Basar-mte/CapLeg/docs/img/ankle_capstan_drive.png

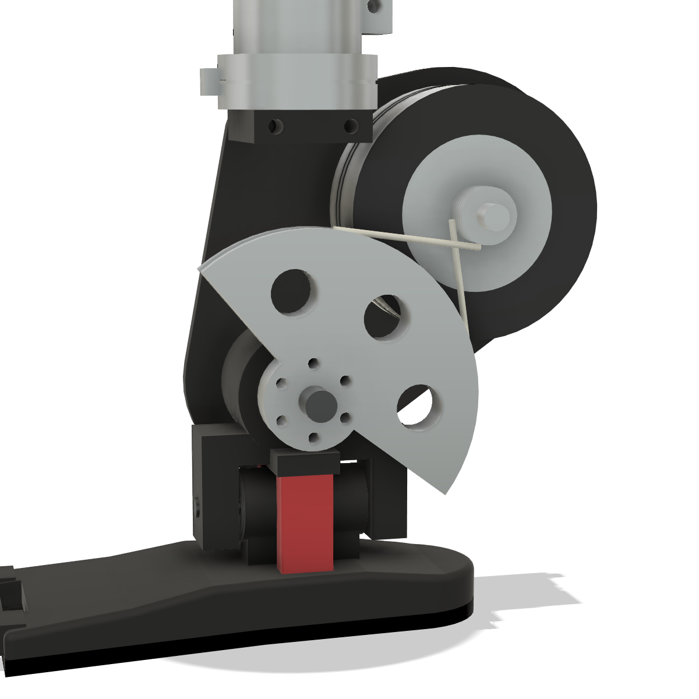
docs/img/ankle_capstan_drive.png
