Basar-mte/CapLeg/docs/img/gait_keyframes.png

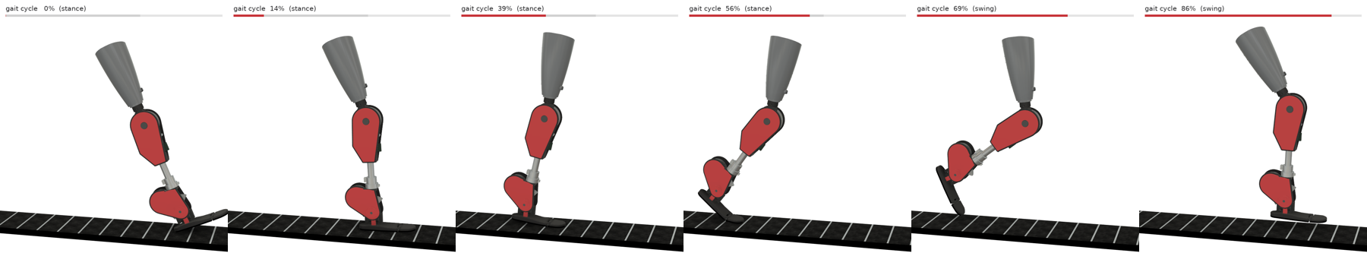
docs/img/gait_keyframes.png
