Basar-mte/CapLeg/docs/img/gait_reference.png

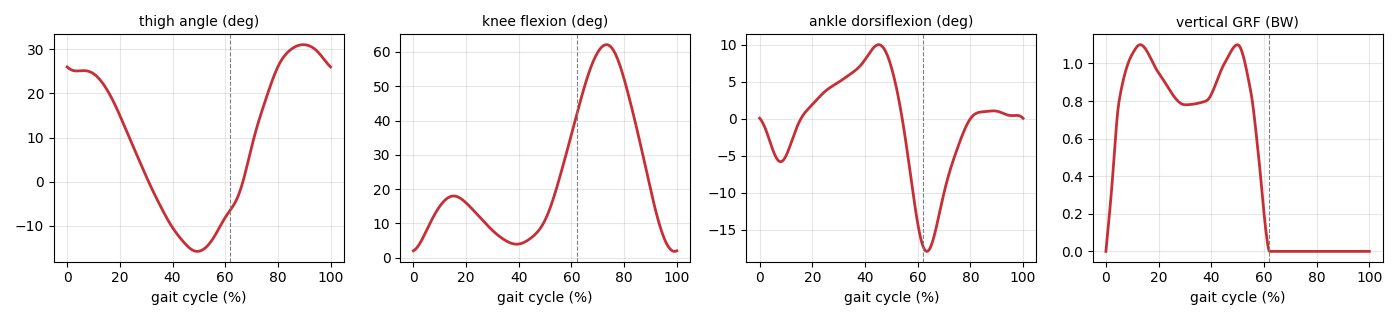
docs/img/gait_reference.png
