Basar-mte/CapLeg/docs/img/knee_capstan_drive.png

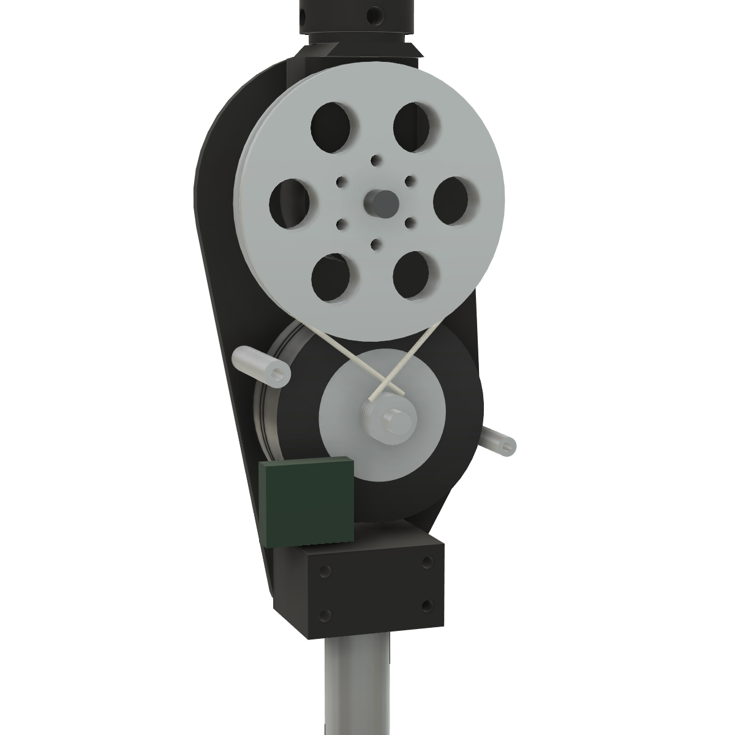
docs/img/knee_capstan_drive.png
