Basar-mte/CapLeg/docs/img/lateral.png

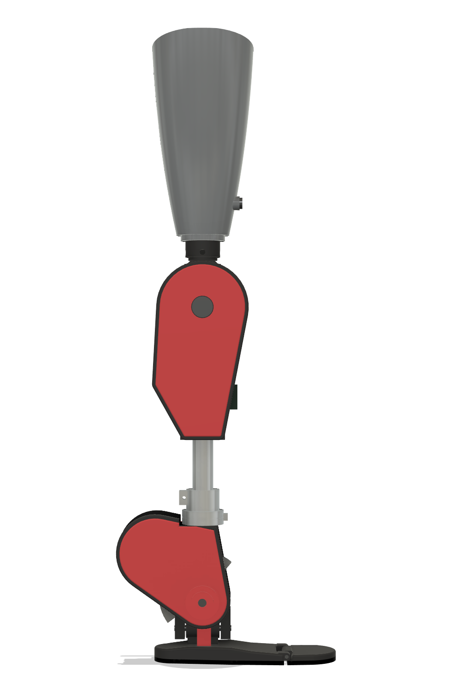
docs/img/lateral.png
