Basar-mte/CapLeg/docs/img/pose_knee120.png

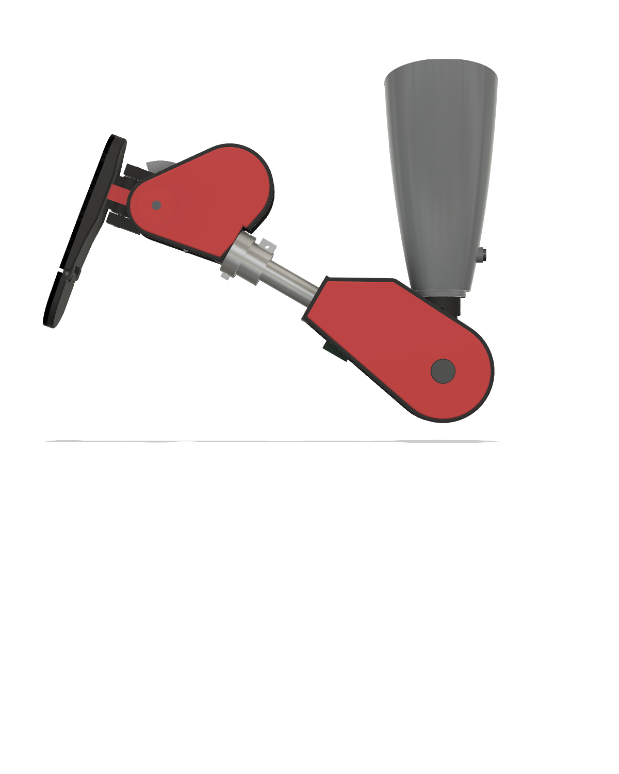
docs/img/pose_knee120.png
