Basar-mte/CapLeg/docs/img/pose_pushoff.png

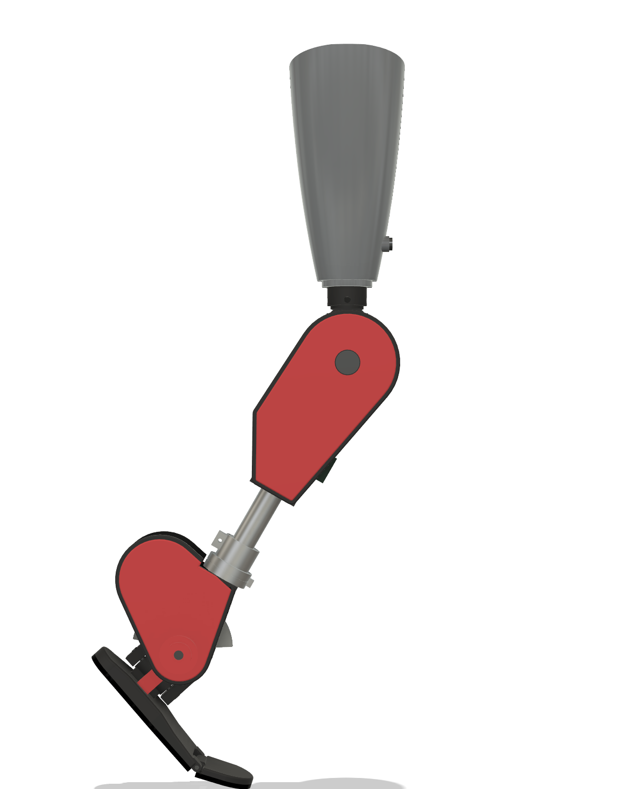
docs/img/pose_pushoff.png
