Basar-mte/CapLeg/docs/img/pose_roll_eversion.png

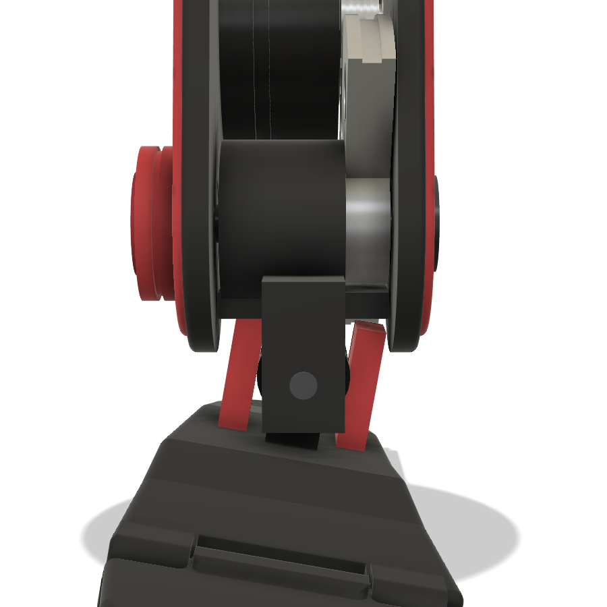
docs/img/pose_roll_eversion.png
