Basar-mte/CapLeg/docs/img/pose_swing.png

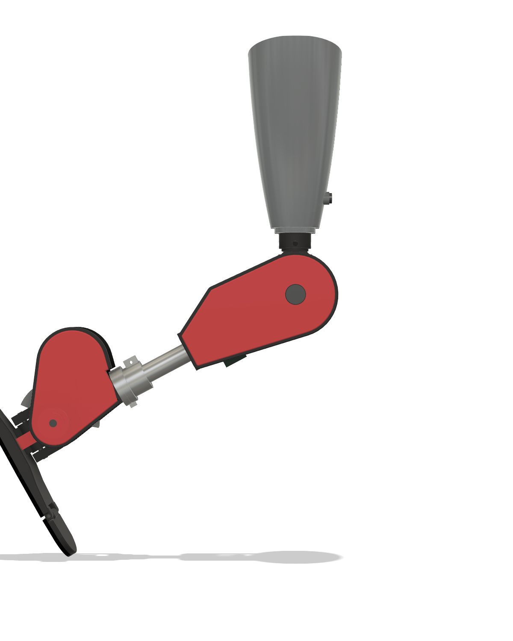
docs/img/pose_swing.png
