Basar-mte/CapLeg/docs/img/rear_medial_iso.png

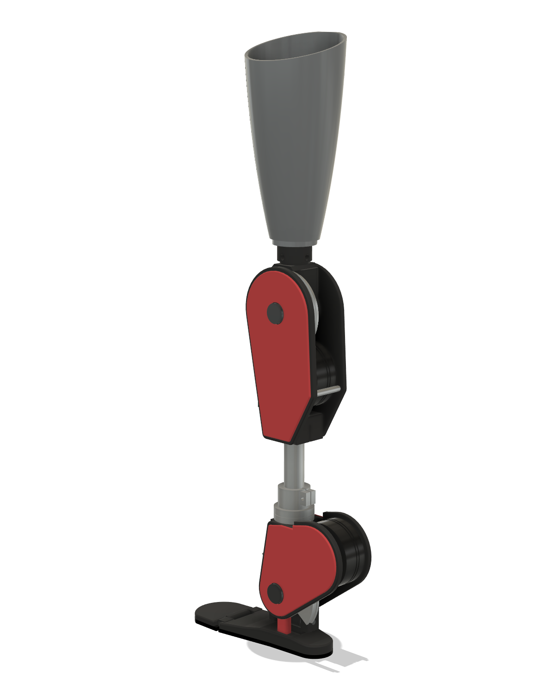
docs/img/rear_medial_iso.png
