Basar-mte/CapLeg/cad/step/CapLeg_assembly.step

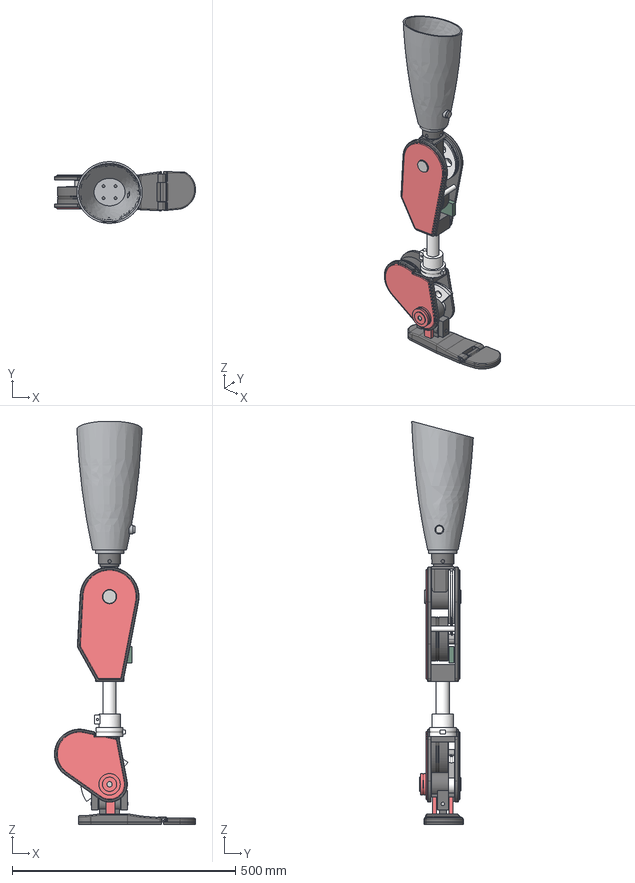
[picture p16: CAD file, 2026-10-10]
cad/step/CapLeg_assembly.step
315.9 x 138.1 x 902.0 mm
CapLeg_Thigh
CapLeg_Shank
CapLeg_Talus
CapLeg_Foot
CapLeg_Toe
