Basar-mte/CapLeg/cad/stl_print/P04_KneeCapstanDisc.stl

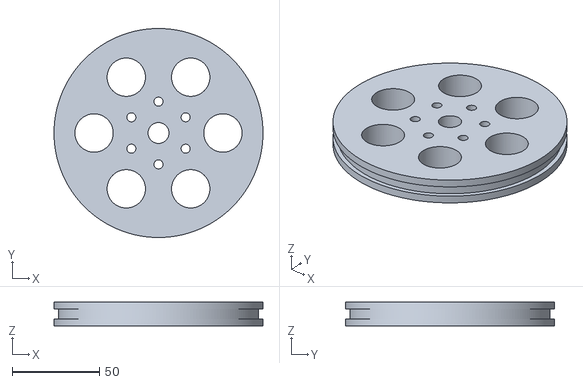
[picture p17: CAD file, 2026-10-10]
cad/stl_print/P04_KneeCapstanDisc.stl
120.0 x 120.0 x 13.5
