Basar-mte/CapLeg/cad/stl_world/H32_OutputFlange.stl

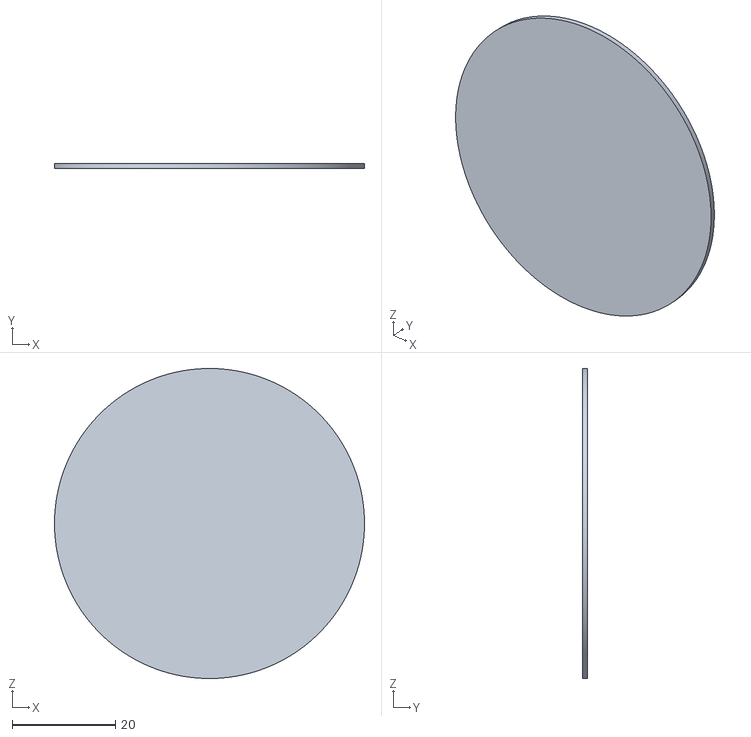
[picture p18: CAD file, 2026-10-10]
cad/stl_world/H32_OutputFlange.stl
60.0 x 1.00 x 60.0
