Basar-mte/CapLeg/mujoco/assets/capleg_shank_pylon__aluminium.stl

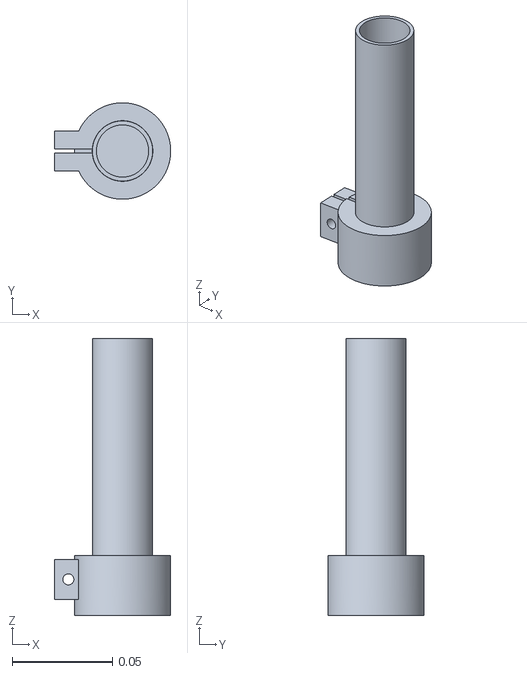
[picture p19: CAD file, 2026-10-10]
mujoco/assets/capleg_shank_pylon__aluminium.stl
0.058 x 0.048 x 0.138
