Basar-mte/CapLeg/ros2_ws/src/capleg_description/meshes/visual/capleg_ankle_module__accent_red.stl

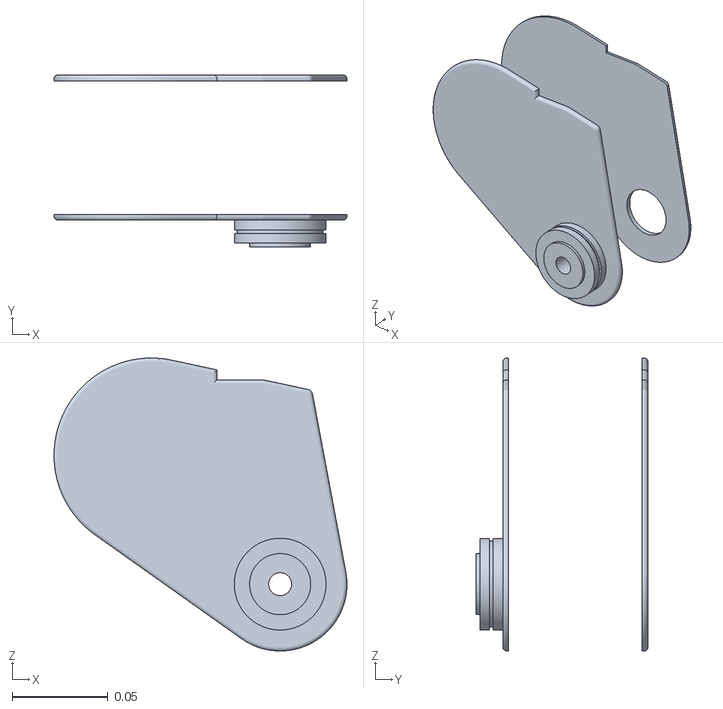
[picture p20: CAD file, 2026-10-10]
ros2_ws/src/capleg_description/meshes/visual/capleg_ankle_module__accent_red.stl
0.153 x 0.09 x 0.153
