Basar-mte/CapLeg/cad/stl_print/P17_PylonClamp_Ankle.stl

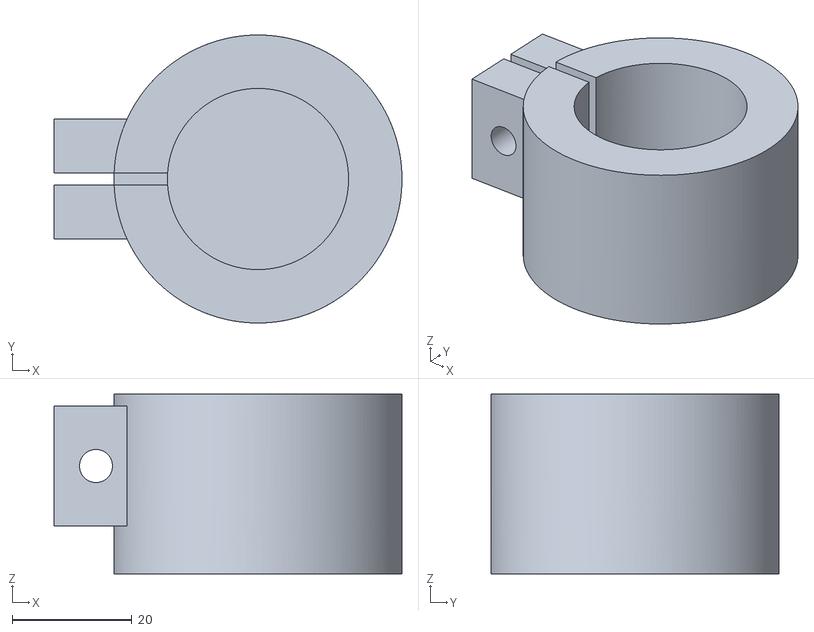
[picture p21: CAD file, 2026-10-10]
cad/stl_print/P17_PylonClamp_Ankle.stl
58.0 x 48.0 x 30.0
