Basar-mte/CapLeg/cad/stl_world/P21_FootKeel.stl

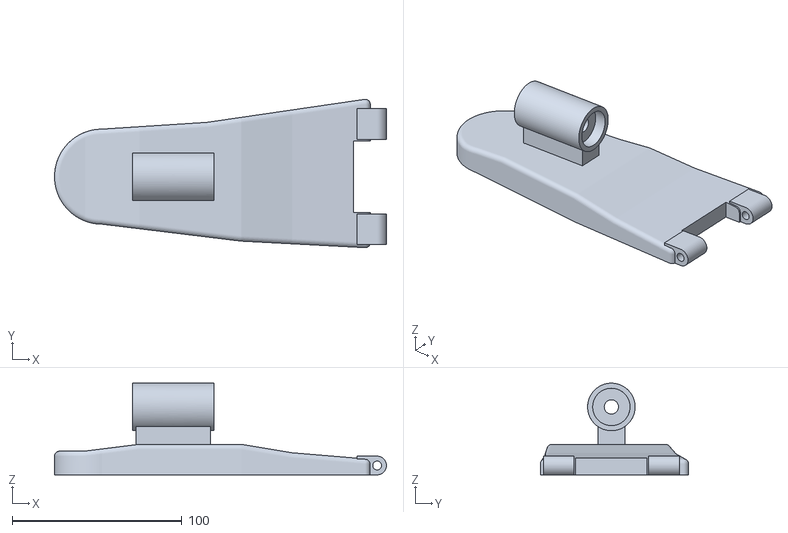
[picture p22: CAD file, 2026-10-10]
cad/stl_world/P21_FootKeel.stl
195.5 x 87.4 x 54.0
