Basar-mte/CapLeg/mujoco/assets/capleg_toe__graphite.stl

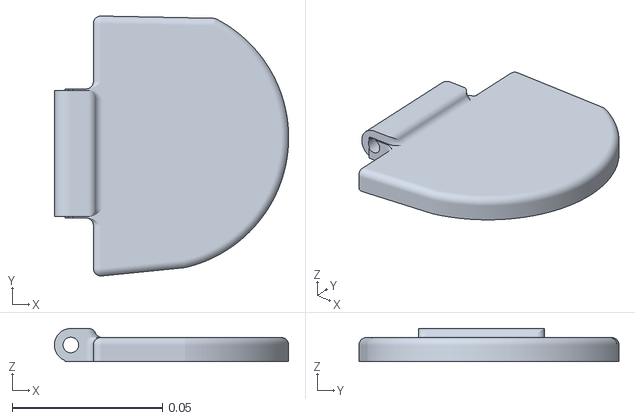
[picture p23: CAD file, 2026-10-10]
mujoco/assets/capleg_toe__graphite.stl
0.078 x 0.0865 x 0.011
