Basar-mte/CapLeg/ros2_ws/src/capleg_description/meshes/visual/capleg_foot__tpu_black.stl

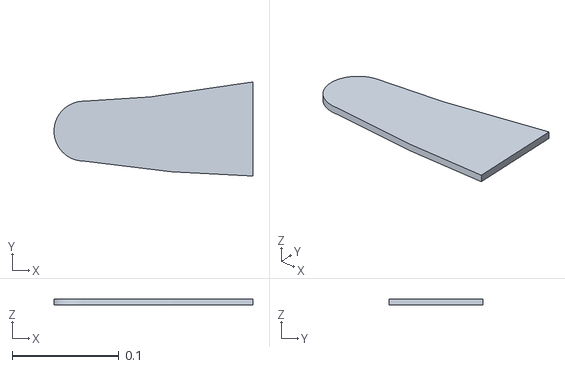
[picture p24: CAD file, 2026-10-10]
ros2_ws/src/capleg_description/meshes/visual/capleg_foot__tpu_black.stl
0.186 x 0.088 x 0.006
