Basar-mte/CapLeg/cad/stl_print/P14_AnkleCover_Lat.stl

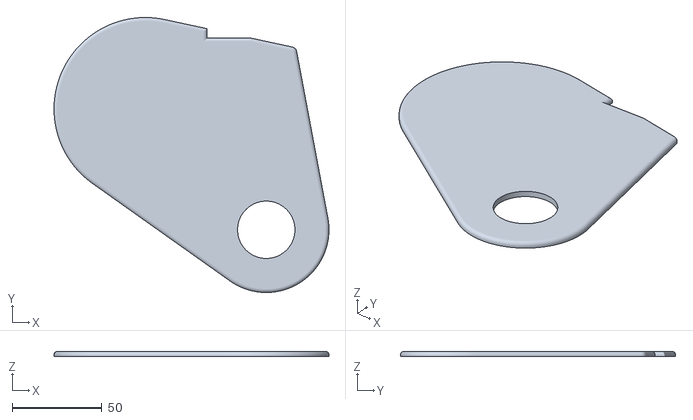
[picture p25: CAD file, 2026-10-10]
cad/stl_print/P14_AnkleCover_Lat.stl
153.4 x 153.4 x 3.00
