Basar-mte/CapLeg/cad/stl_world/P05_KneePlate_Lat.stl

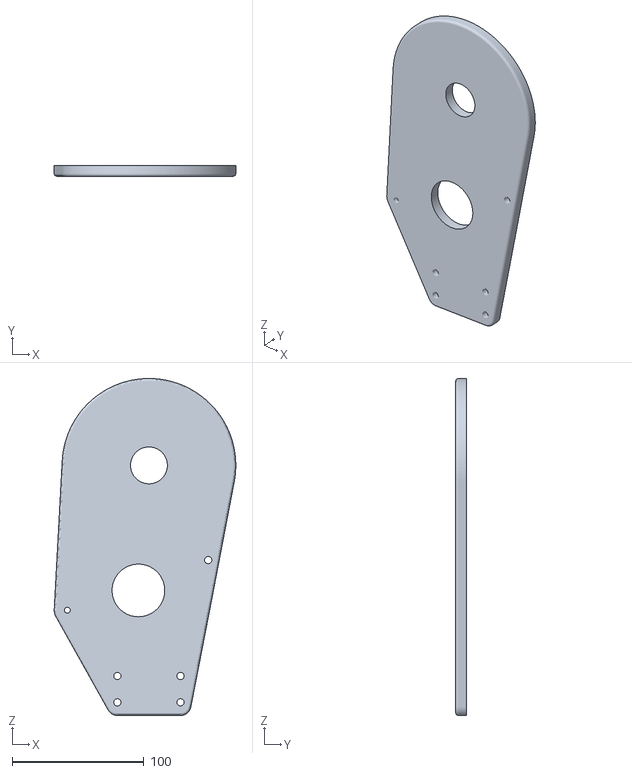
[picture p26: CAD file, 2026-10-10]
cad/stl_world/P05_KneePlate_Lat.stl
138.0 x 8.00 x 256.0
