Basar-mte/CapLeg/mujoco/assets/capleg_thigh__smoke_clear.stl

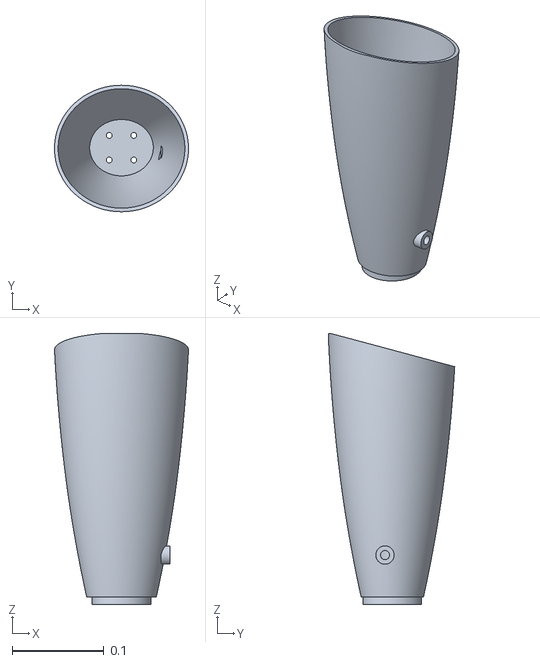
[picture p27: CAD file, 2026-10-10]
mujoco/assets/capleg_thigh__smoke_clear.stl
0.146 x 0.138 x 0.296
