Basar-mte/CapLeg/ros2_ws/src/capleg_description/meshes/visual/capleg_shank_knee__graphite.stl

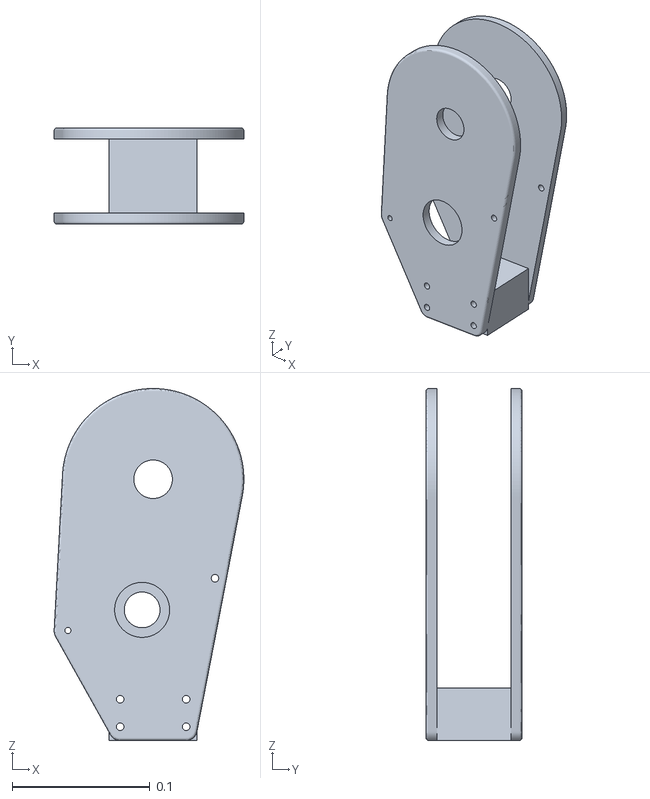
[picture p28: CAD file, 2026-10-10]
ros2_ws/src/capleg_description/meshes/visual/capleg_shank_knee__graphite.stl
0.138 x 0.07 x 0.256
