Basar-mte/CapLeg/cad/stl_print/P03_KneeHead.stl

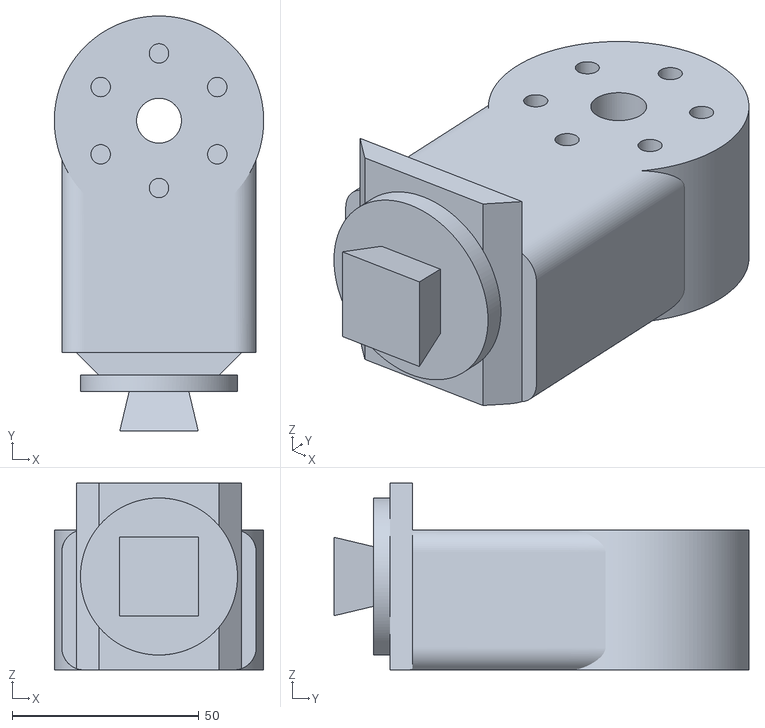
[picture p29: CAD file, 2026-10-10]
cad/stl_print/P03_KneeHead.stl
56.0 x 111.0 x 50.0
