Basar-mte/CapLeg/cad/stl_world/H31_Actuator_AK80-9.stl

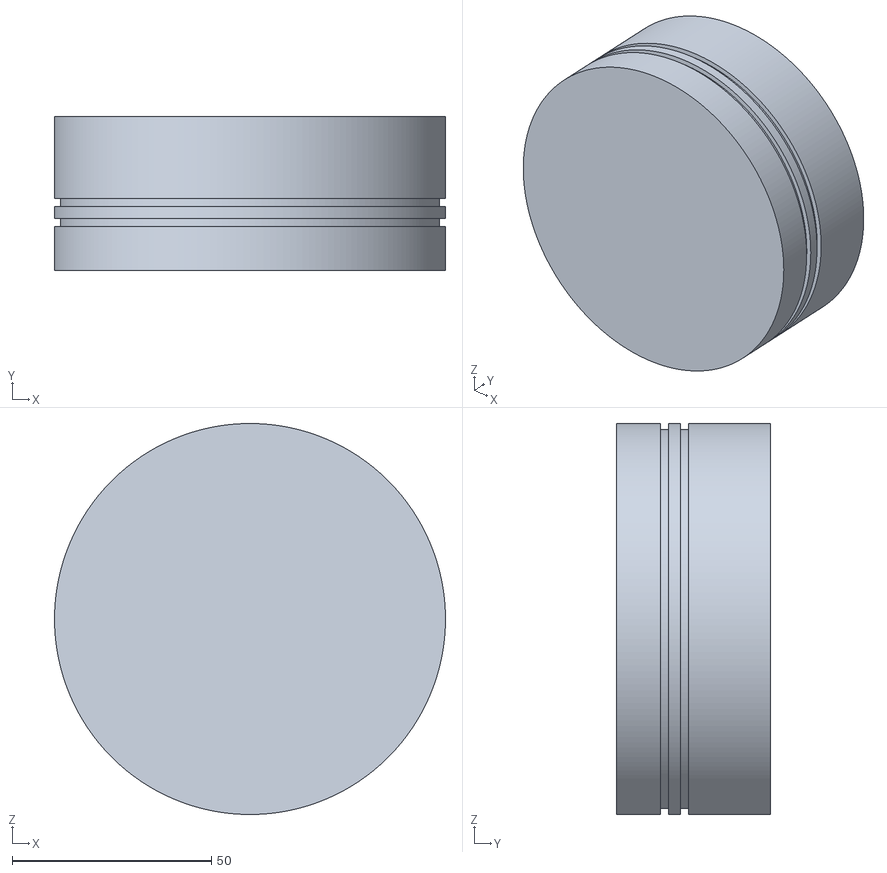
[picture p30: CAD file, 2026-10-10]
cad/stl_world/H31_Actuator_AK80-9.stl
98.0 x 38.5 x 98.0
