Basar-mte/CapLeg/mujoco/assets/capleg_foot__graphite.stl

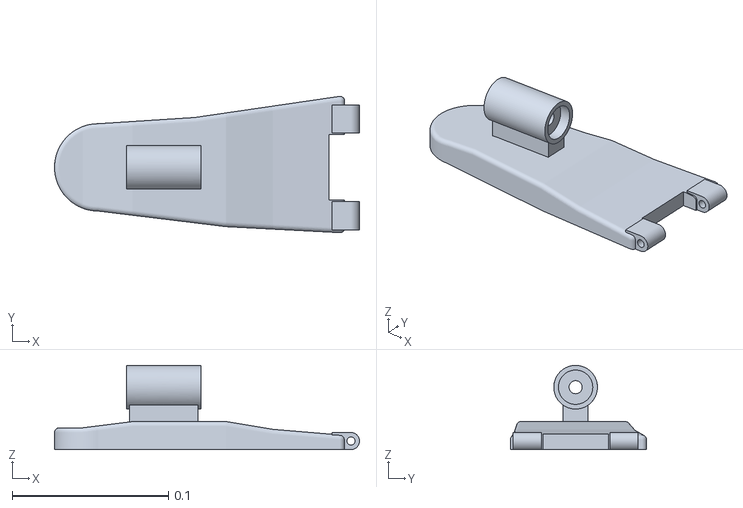
[picture p31: CAD file, 2026-10-10]
mujoco/assets/capleg_foot__graphite.stl
0.195 x 0.0874 x 0.054
