Basar-mte/CapLeg/ros2_ws/src/capleg_description/meshes/visual/capleg_foot__accent_red.stl

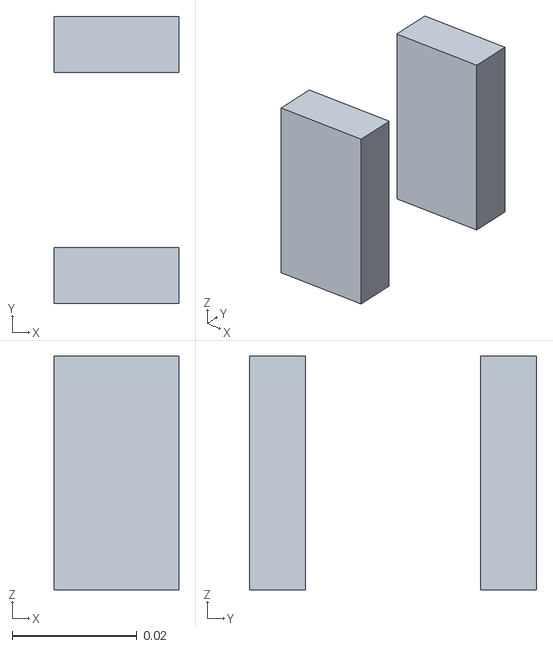
[picture p32: CAD file, 2026-10-10]
ros2_ws/src/capleg_description/meshes/visual/capleg_foot__accent_red.stl
0.02 x 0.046 x 0.0375
