Basar-mte/CapLeg/cad/stl_print/P23_RollSpring_TPU_Med.stl

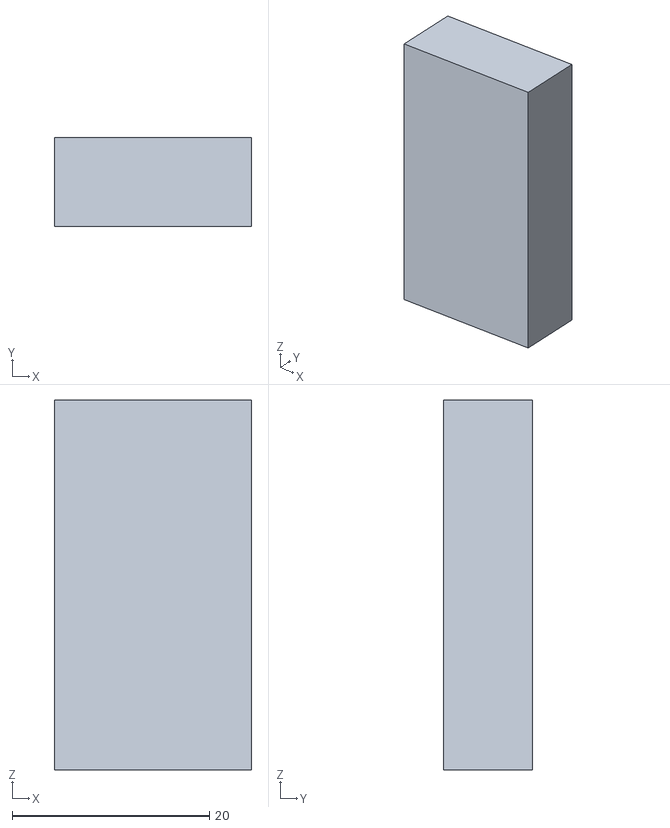
[picture p33: CAD file, 2026-10-10]
cad/stl_print/P23_RollSpring_TPU_Med.stl
20.0 x 9.00 x 37.5
