Basar-mte/CapLeg/mujoco/assets/capleg_talus__steel.stl

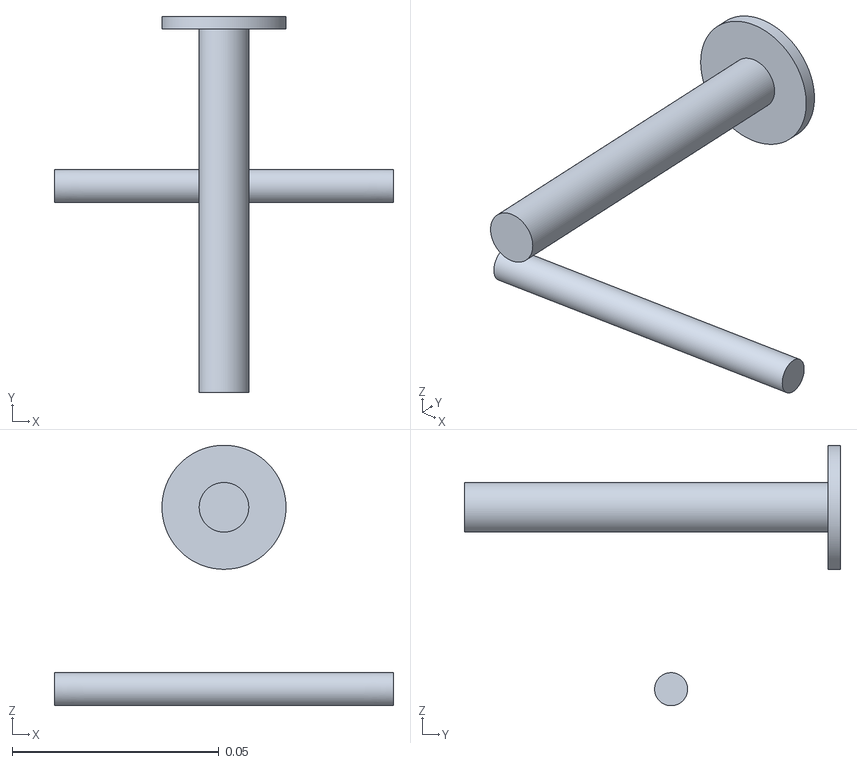
[picture p34: CAD file, 2026-10-10]
mujoco/assets/capleg_talus__steel.stl
0.082 x 0.091 x 0.063
