Basar-mte/CapLeg/ros2_ws/src/capleg_description/meshes/visual/capleg_shank_knee__aluminium.stl

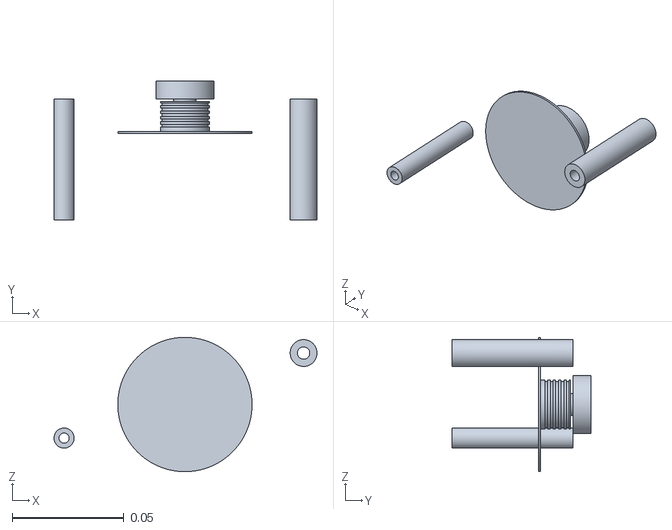
[picture p35: CAD file, 2026-10-10]
ros2_ws/src/capleg_description/meshes/visual/capleg_shank_knee__aluminium.stl
0.117 x 0.062 x 0.06
