Basar-mte/CapLeg/cad/stl_print/P02_PyramidReceiver.stl

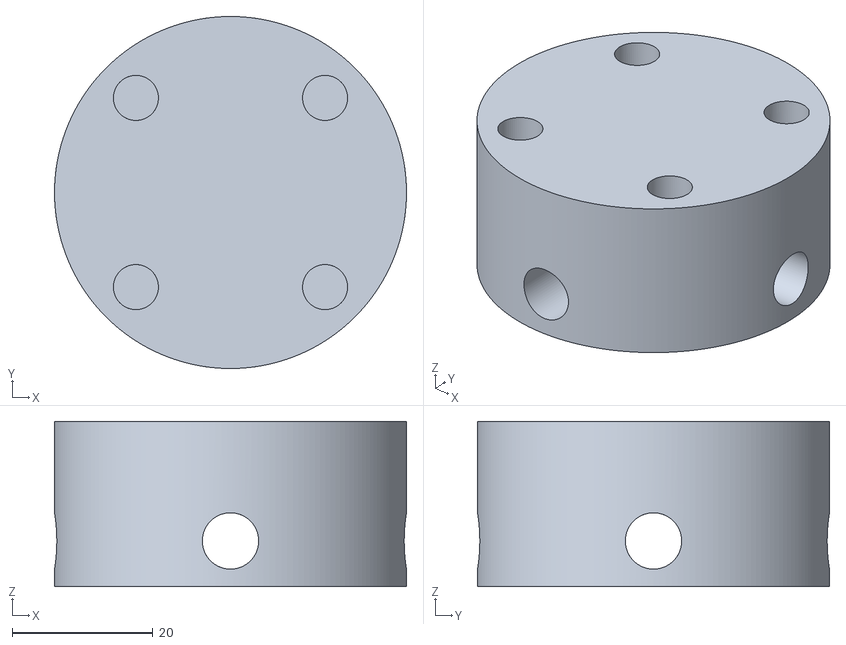
[picture p36: CAD file, 2026-10-10]
cad/stl_print/P02_PyramidReceiver.stl
50.0 x 50.0 x 23.5
