Basar-mte/CapLeg/cad/stl_world/P11_AnklePlate_Lat.stl

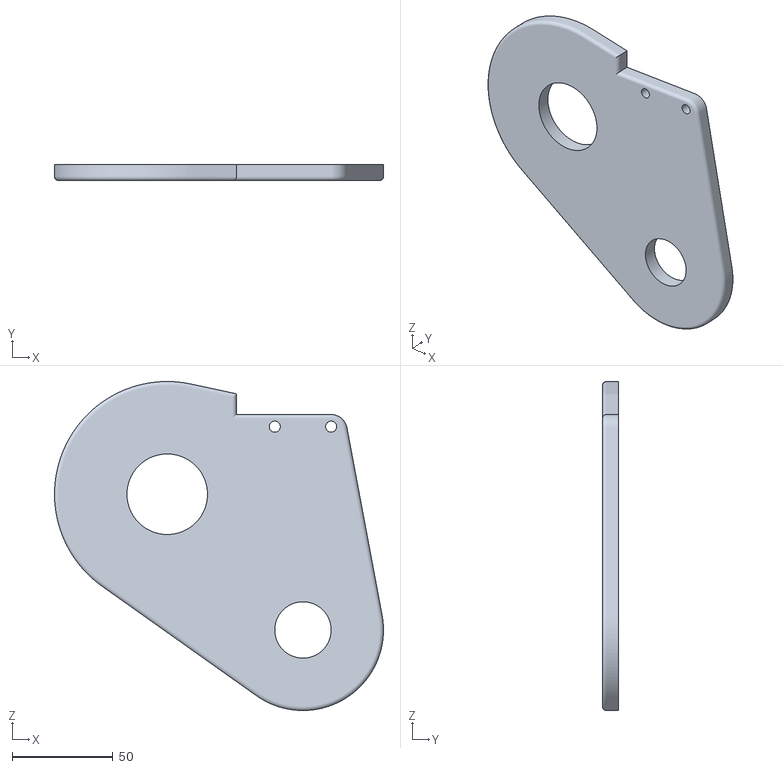
[picture p37: CAD file, 2026-10-10]
cad/stl_world/P11_AnklePlate_Lat.stl
163.4 x 8.00 x 163.4
