Basar-mte/CapLeg/mujoco/assets/capleg_toe__tpu_black.stl

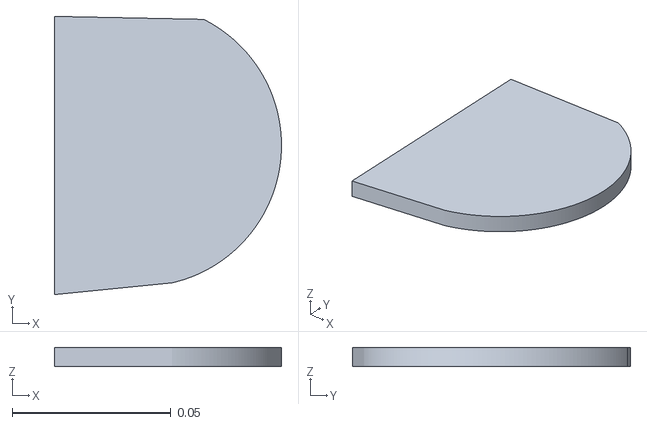
[picture p38: CAD file, 2026-10-10]
mujoco/assets/capleg_toe__tpu_black.stl
0.0715 x 0.0876 x 0.006
