Basar-mte/CapLeg/cad/stl_print/P16_PEA_SpringCartridge.stl

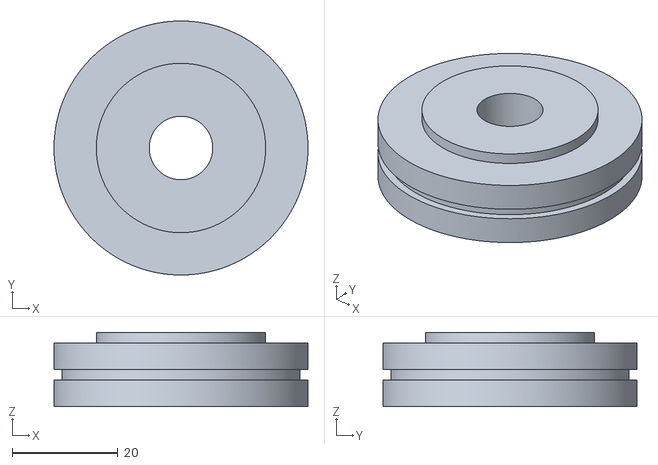
[picture p39: CAD file, 2026-10-10]
cad/stl_print/P16_PEA_SpringCartridge.stl
48.0 x 48.0 x 14.0
