Basar-mte/CapLeg/ros2_ws/src/capleg_description/meshes/visual/capleg_ankle_module__cable_white.stl

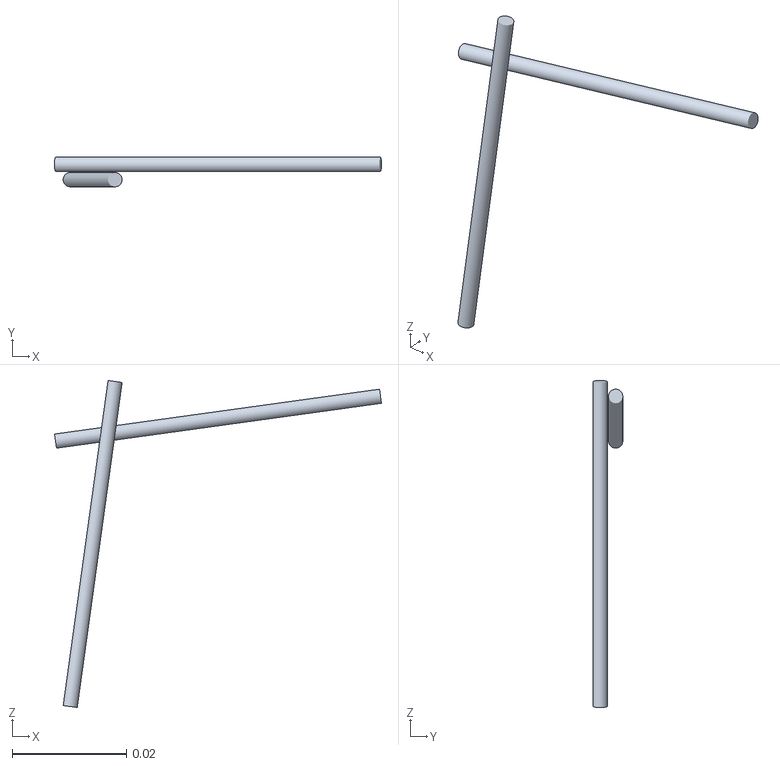
[picture p40: CAD file, 2026-10-10]
ros2_ws/src/capleg_description/meshes/visual/capleg_ankle_module__cable_white.stl
0.0574 x 0.00519 x 0.0574
