Basar-mte/CapLeg/cad/stl_print/P12_AnklePlate_Med.stl

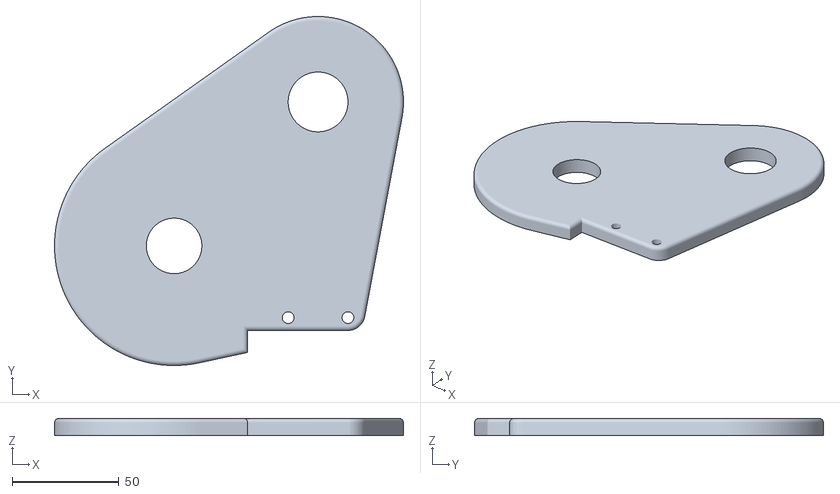
[picture p41: CAD file, 2026-10-10]
cad/stl_print/P12_AnklePlate_Med.stl
163.4 x 163.4 x 8.00
