Basar-mte/CapLeg/mujoco/assets/capleg_ankle_module__aluminium.stl

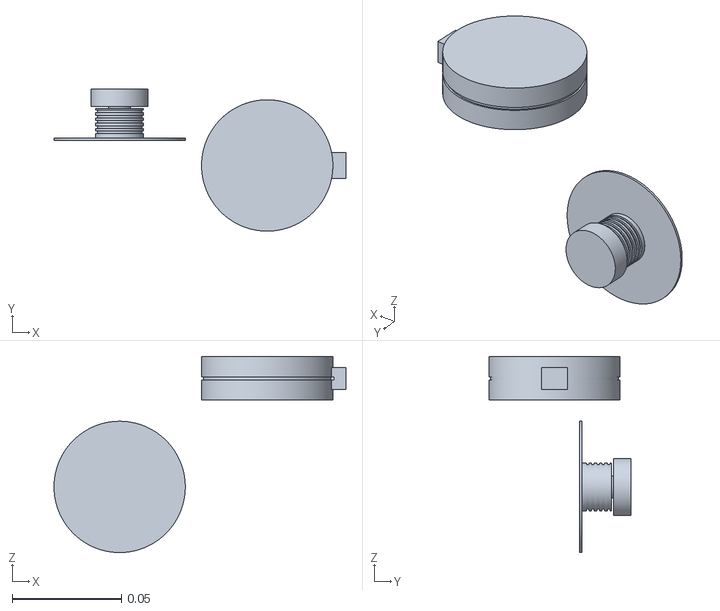
[picture p42: CAD file, 2026-10-10]
mujoco/assets/capleg_ankle_module__aluminium.stl
0.133 x 0.065 x 0.0896
