Basar-mte/CapLeg/ros2_ws/src/capleg_description/meshes/visual/capleg_ankle_module__graphite.stl

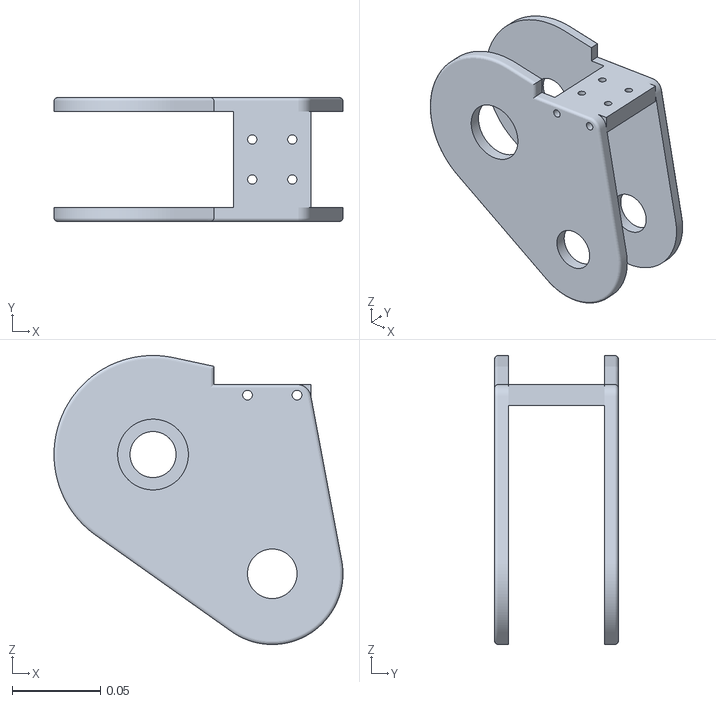
[picture p43: CAD file, 2026-10-10]
ros2_ws/src/capleg_description/meshes/visual/capleg_ankle_module__graphite.stl
0.163 x 0.07 x 0.163
