Basar-mte/CapLeg/cad/stl_print/P06_KneePlate_Med.stl

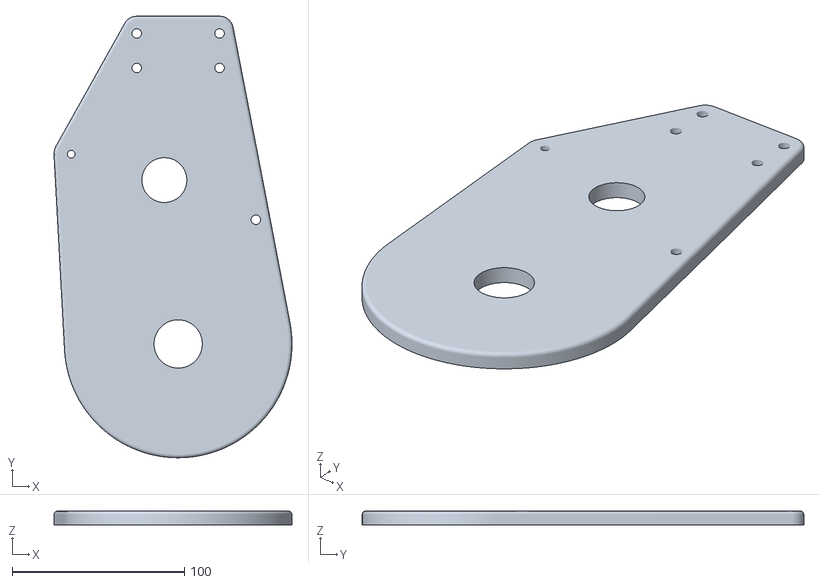
[picture p44: CAD file, 2026-10-10]
cad/stl_print/P06_KneePlate_Med.stl
138.0 x 256.0 x 8.00
