Basar-mte/CapLeg/cad/stl_world/P20_AnkleCapstanSector.stl

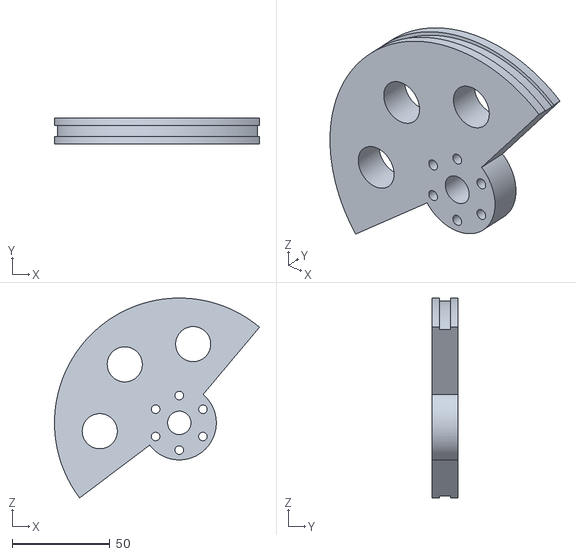
[picture p45: CAD file, 2026-10-10]
cad/stl_world/P20_AnkleCapstanSector.stl
105.1 x 13.5 x 102.5
