Basar-mte/CapLeg/mujoco/assets/capleg_shank_knee__steel.stl

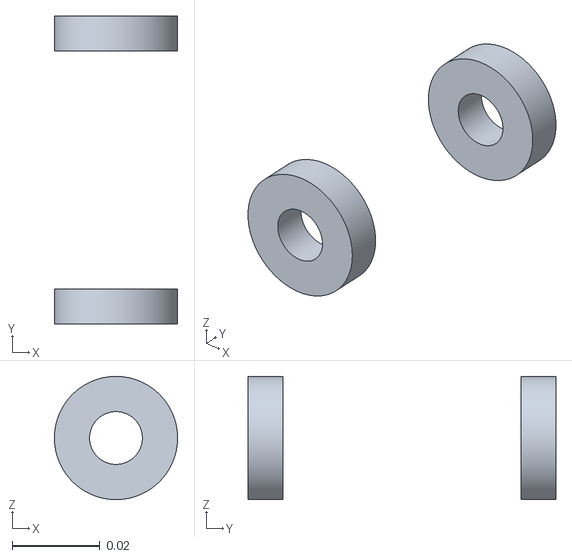
[picture p46: CAD file, 2026-10-10]
mujoco/assets/capleg_shank_knee__steel.stl
0.028 x 0.07 x 0.028
