Basar-mte/CapLeg/cad/stl_print/P13_AnkleTopBlock.stl

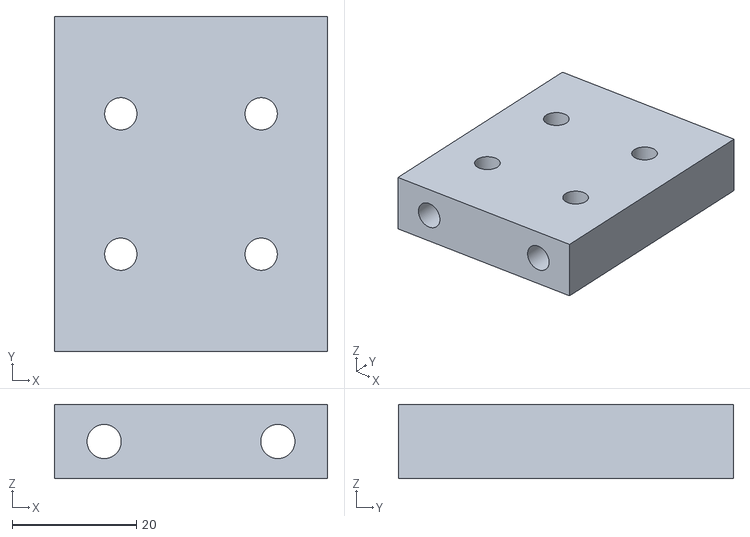
[picture p47: CAD file, 2026-10-10]
cad/stl_print/P13_AnkleTopBlock.stl
44.0 x 54.0 x 12.0
