Basar-mte/CapLeg/cad/stl_world/P10_CapstanDrum.stl

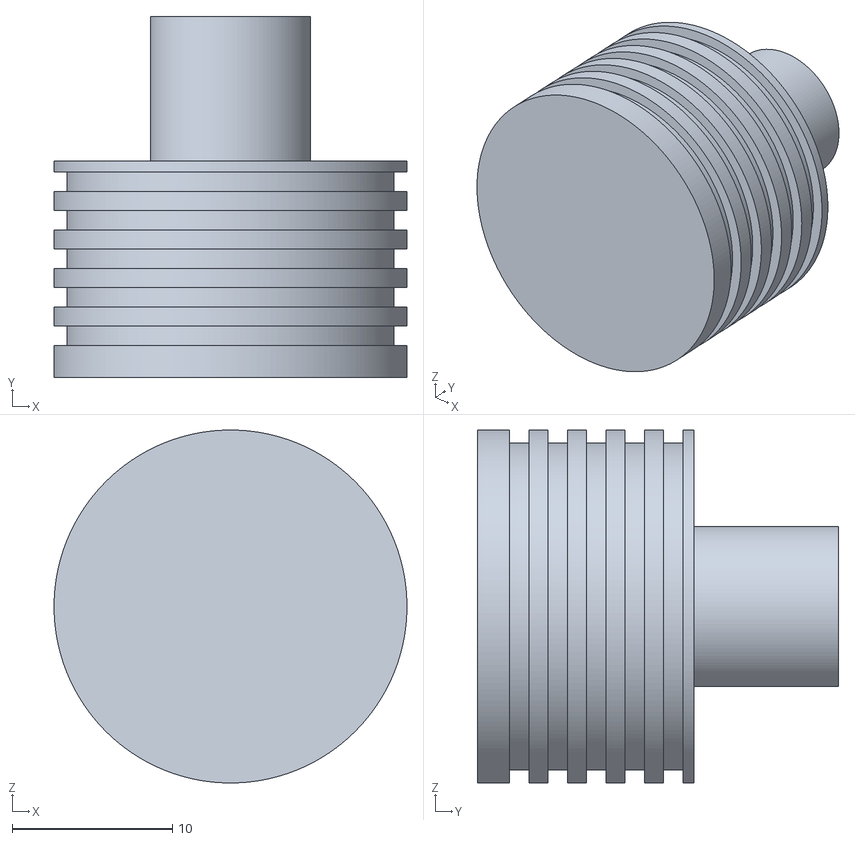
[picture p48: CAD file, 2026-10-10]
cad/stl_world/P10_CapstanDrum.stl
22.0 x 22.5 x 22.0
