Basar-mte/CapLeg/mujoco/assets/capleg_thigh__steel.stl

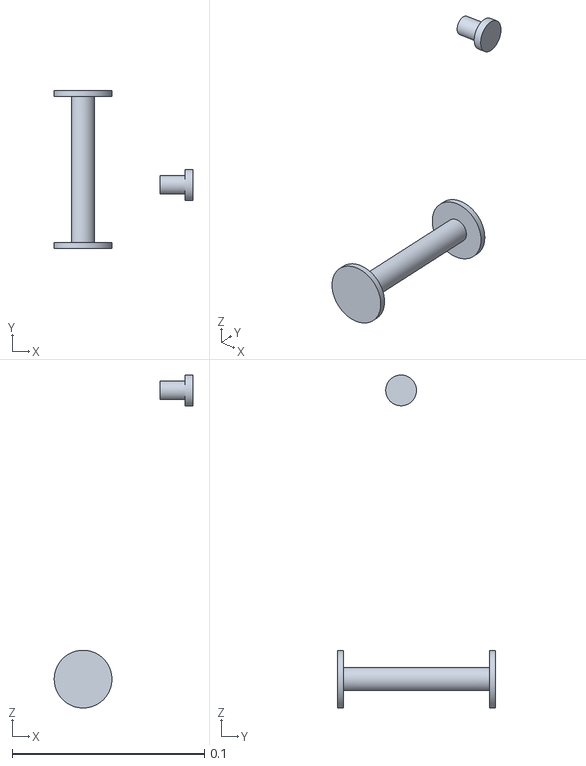
[picture p49: CAD file, 2026-10-10]
mujoco/assets/capleg_thigh__steel.stl
0.072 x 0.082 x 0.173
