Basar-mte/CapLeg/cad/stl_world/H13_KneeCable_2.stl

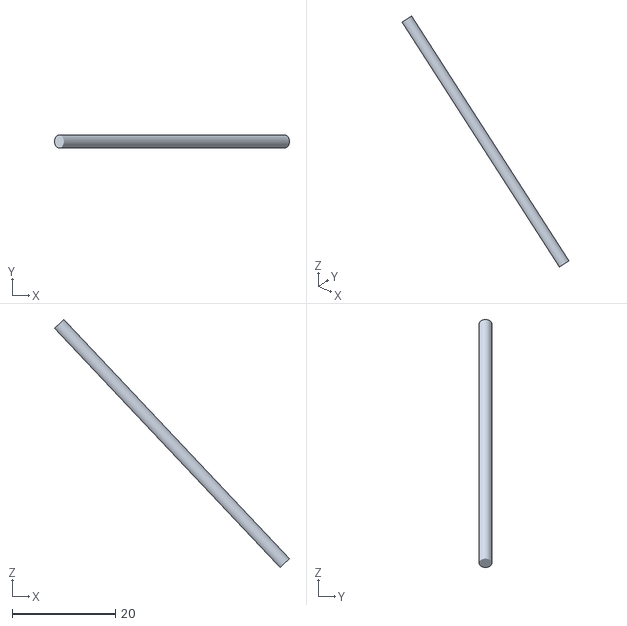
[picture p50: CAD file, 2026-10-10]
cad/stl_world/H13_KneeCable_2.stl
45.5 x 2.50 x 48.0
