Basar-mte/CapLeg/ros2_ws/src/capleg_description/meshes/visual/capleg_thigh__aluminium.stl

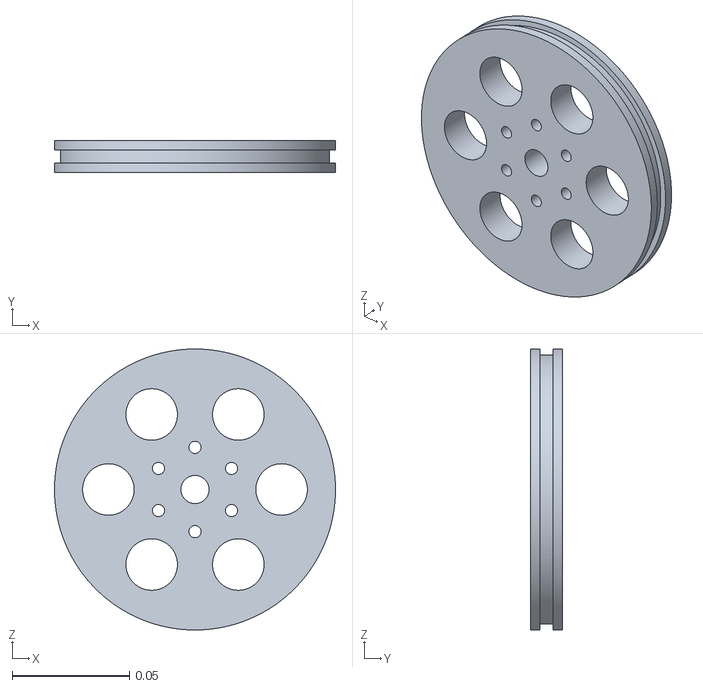
[picture p51: CAD file, 2026-10-10]
ros2_ws/src/capleg_description/meshes/visual/capleg_thigh__aluminium.stl
0.12 x 0.0135 x 0.12
