Basar-mte/CapLeg/cad/stl_world/H02_KneeCap_Lat.stl

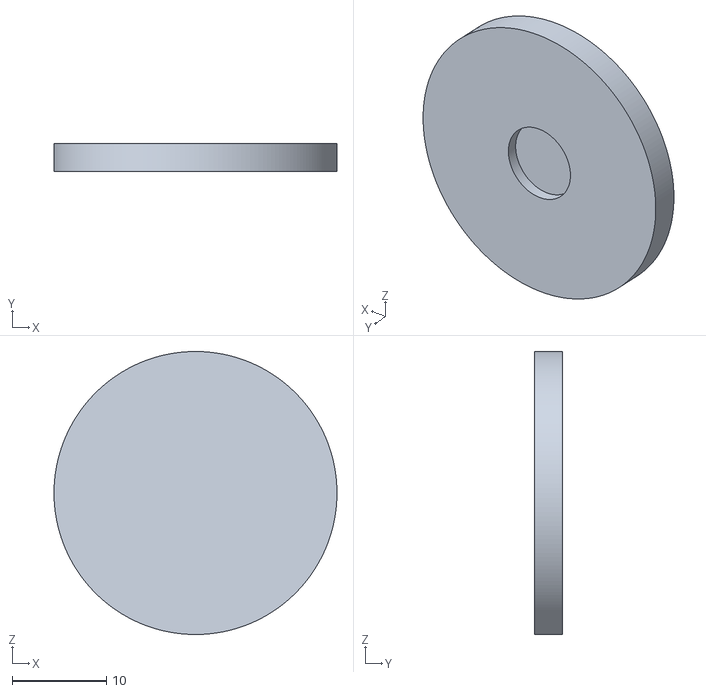
[picture p52: CAD file, 2026-10-10]
cad/stl_world/H02_KneeCap_Lat.stl
30.0 x 3.00 x 30.0
