Basar-mte/CapLeg/mujoco/assets/capleg_shank_knee__accent_red.stl

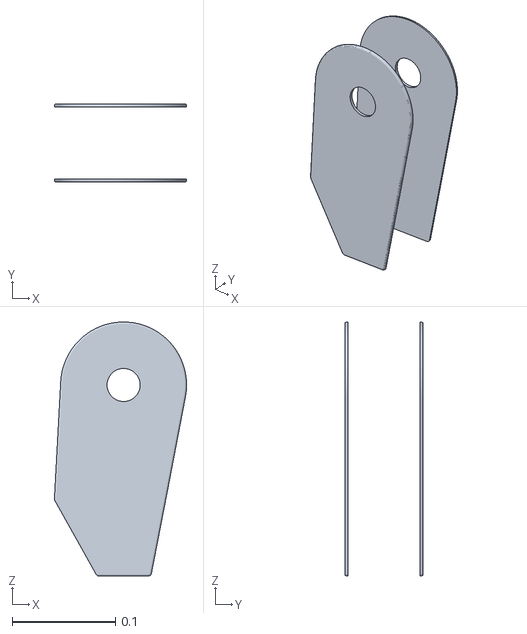
[picture p53: CAD file, 2026-10-10]
mujoco/assets/capleg_shank_knee__accent_red.stl
0.128 x 0.076 x 0.246
