Basar-mte/CapLeg/cad/stl_world/H21_LoadCell_6axis.stl

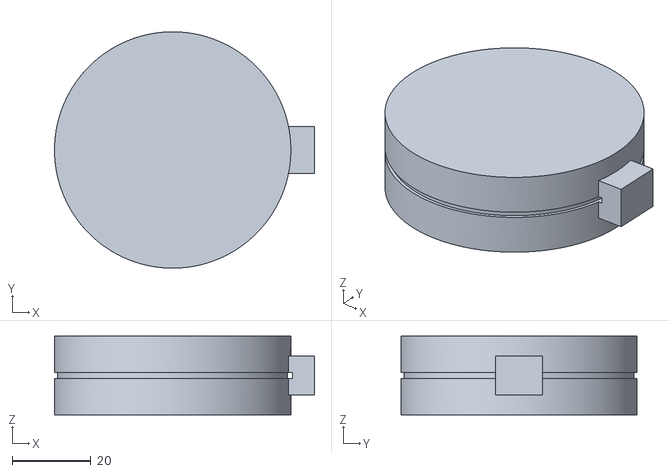
[picture p54: CAD file, 2026-10-10]
cad/stl_world/H21_LoadCell_6axis.stl
66.0 x 60.0 x 20.0
