Basar-mte/CapLeg/cad/stl_print/P22_SolePad_TPU.stl

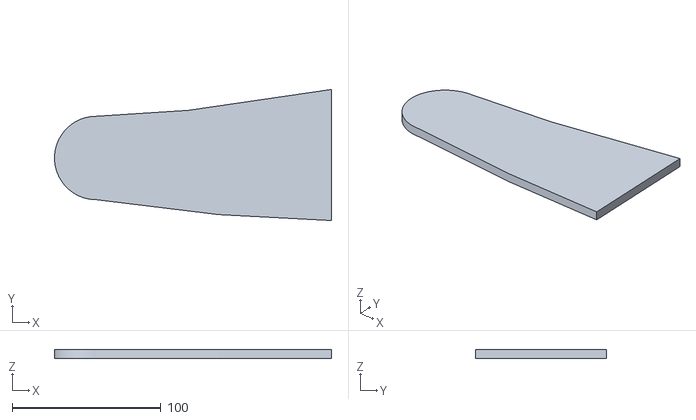
[picture p55: CAD file, 2026-10-10]
cad/stl_print/P22_SolePad_TPU.stl
186.0 x 88.0 x 6.00
