Basar-mte/CapLeg/cad/stl_print/P25_ToePad_TPU.stl

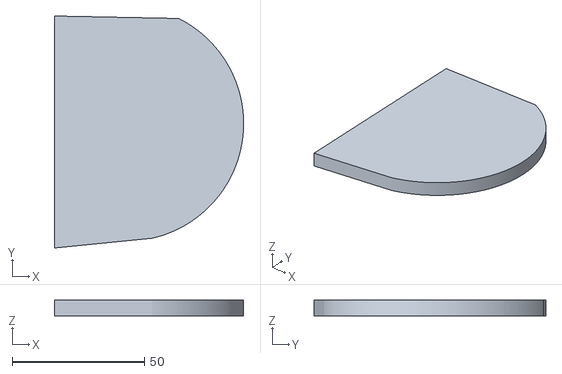
[picture p56: CAD file, 2026-10-10]
cad/stl_print/P25_ToePad_TPU.stl
71.5 x 87.6 x 6.00
