Basar-mte/CapLeg/cad/stl_world/H13_KneeCable_1.stl

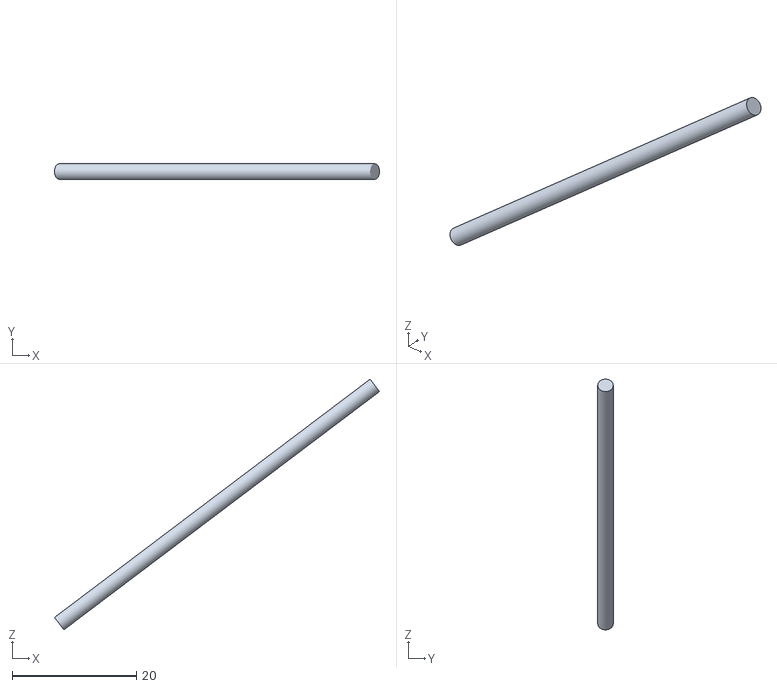
[picture p57: CAD file, 2026-10-10]
cad/stl_world/H13_KneeCable_1.stl
52.3 x 2.50 x 40.3
