Basar-mte/CapLeg/mujoco/assets/capleg_talus__graphite.stl

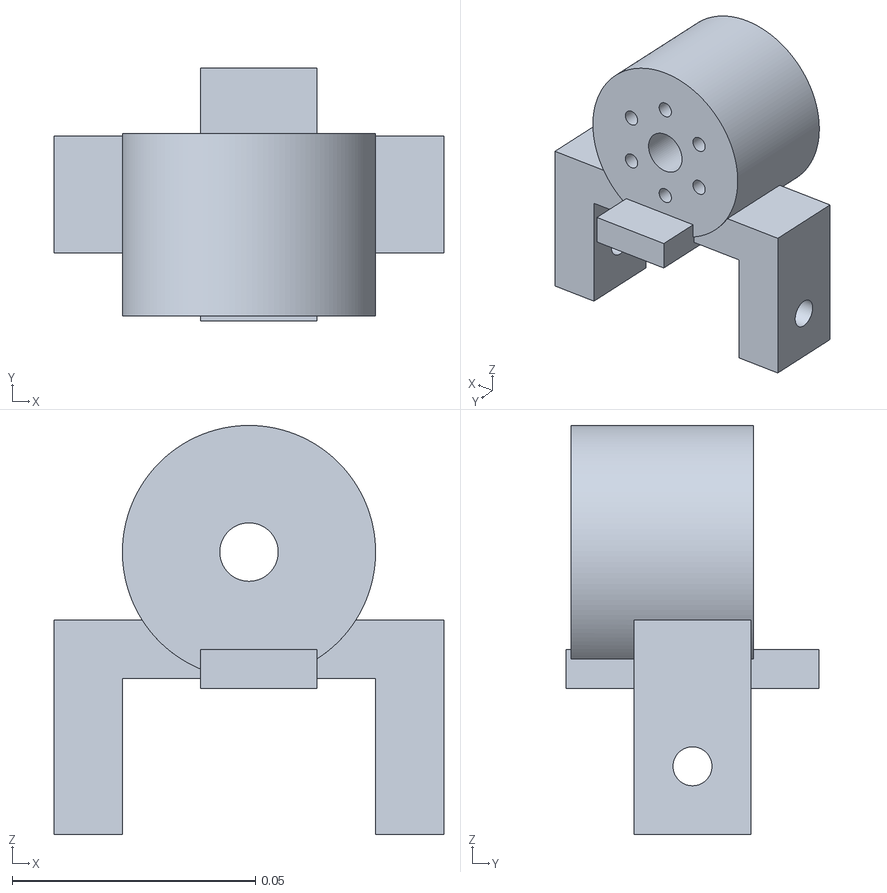
[picture p58: CAD file, 2026-10-10]
mujoco/assets/capleg_talus__graphite.stl
0.08 x 0.052 x 0.084
