Basar-mte/CapLeg/cad/stl_print/P08_KneeCover_Lat.stl

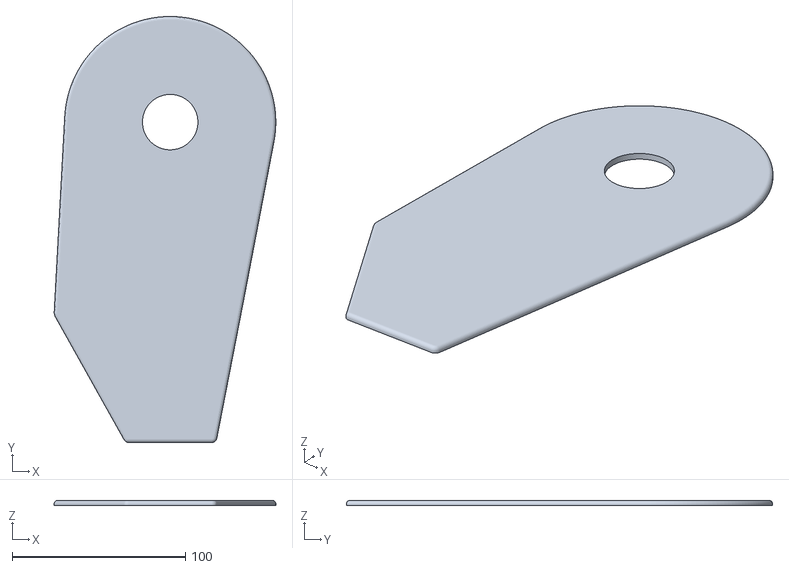
[picture p59: CAD file, 2026-10-10]
cad/stl_print/P08_KneeCover_Lat.stl
128.0 x 246.0 x 3.00
