Basar-mte/CapLeg/ros2_ws/src/capleg_description/meshes/visual/capleg_shank_knee__cable_white.stl

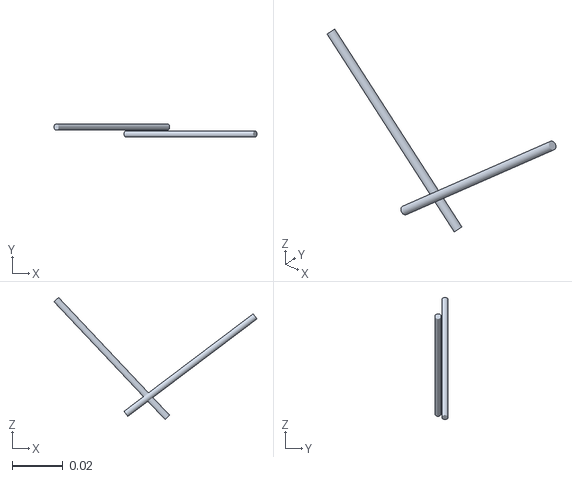
[picture p60: CAD file, 2026-10-10]
ros2_ws/src/capleg_description/meshes/visual/capleg_shank_knee__cable_white.stl
0.0798 x 0.0052 x 0.048
