Basar-mte/CapLeg/cad/stl_print/P07_KneeClamp.stl

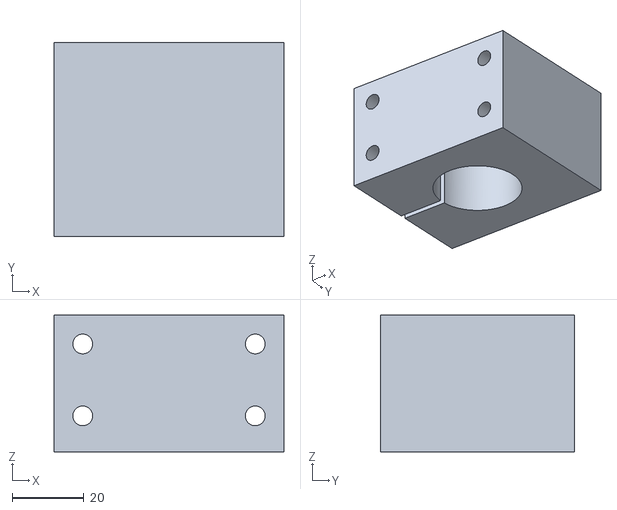
[picture p61: CAD file, 2026-10-10]
cad/stl_print/P07_KneeClamp.stl
64.0 x 54.0 x 38.0
