Basar-mte/CapLeg/cad/stl_world/H51_Bearing608_Ant.stl

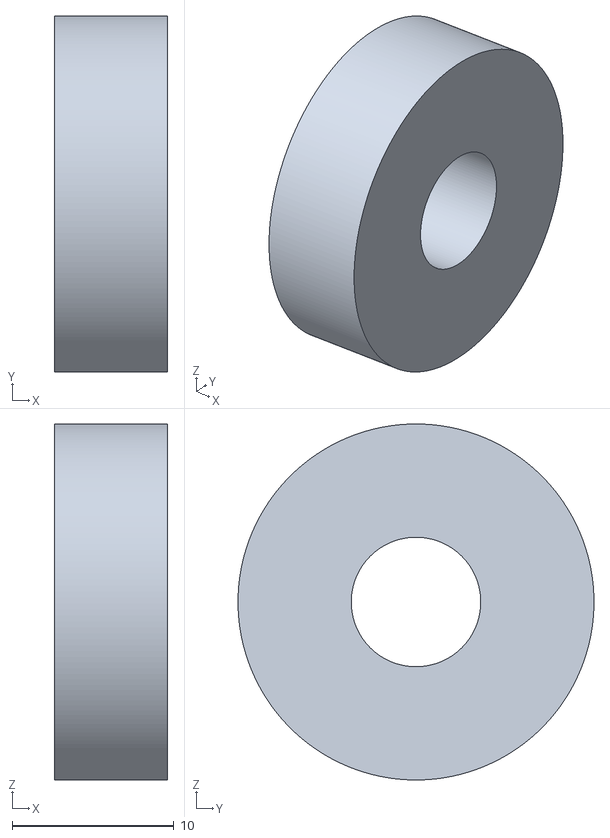
[picture p62: CAD file, 2026-10-10]
cad/stl_world/H51_Bearing608_Ant.stl
7.00 x 22.0 x 22.0
