Basar-mte/CapLeg/mujoco/assets/capleg_foot__steel.stl

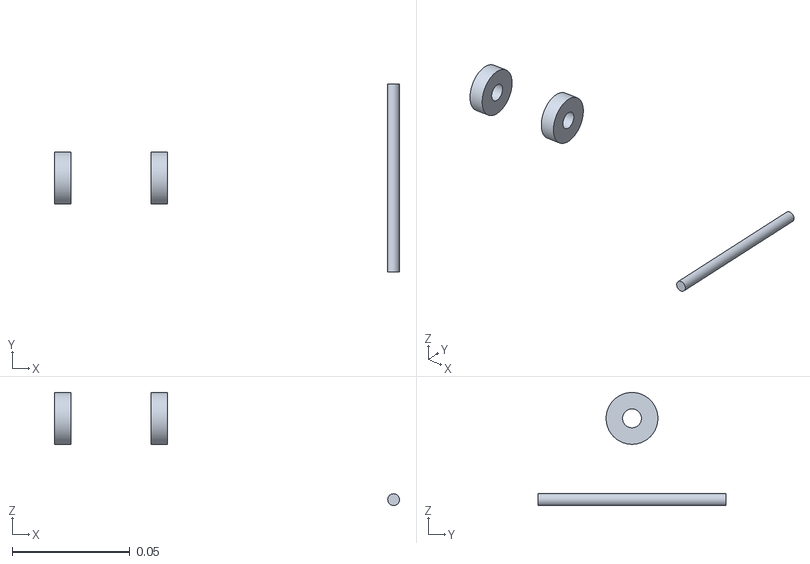
[picture p63: CAD file, 2026-10-10]
mujoco/assets/capleg_foot__steel.stl
0.147 x 0.08 x 0.048
