Basar-mte/CapLeg/ros2_ws/src/capleg_description/meshes/visual/capleg_ankle_module__actuator_black.stl

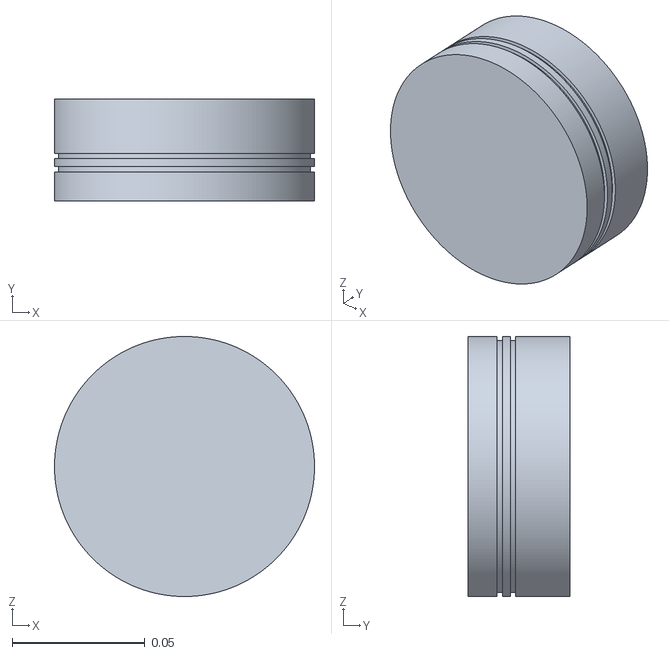
[picture p64: CAD file, 2026-10-10]
ros2_ws/src/capleg_description/meshes/visual/capleg_ankle_module__actuator_black.stl
0.098 x 0.0385 x 0.098
