Basar-mte/CapLeg/mujoco/assets/capleg_talus__aluminium.stl

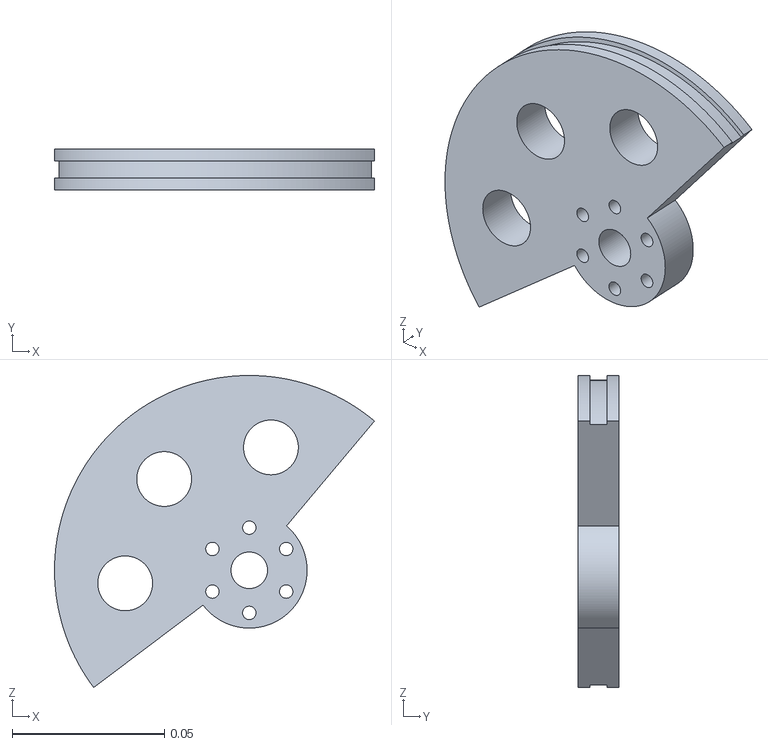
[picture p65: CAD file, 2026-10-10]
mujoco/assets/capleg_talus__aluminium.stl
0.105 x 0.0135 x 0.103
