Basar-mte/CapLeg/cad/stl_print/P24_Toe.stl

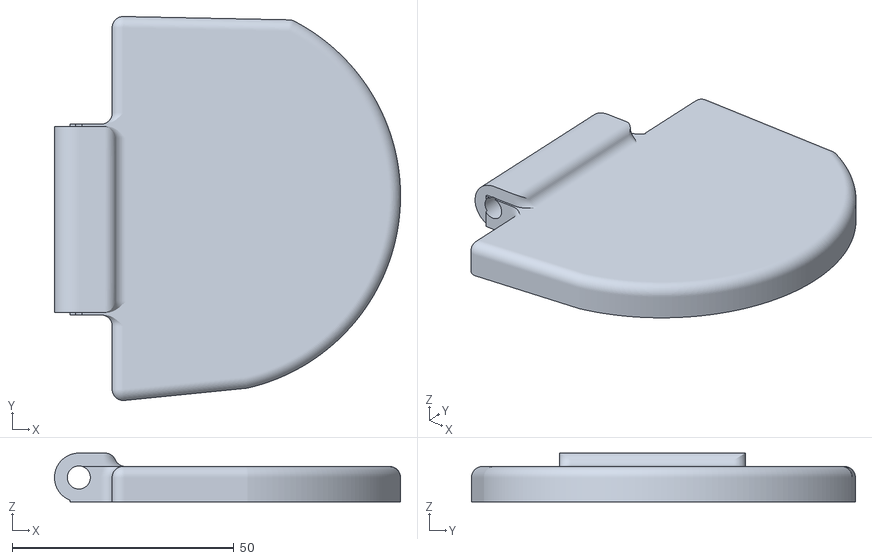
[picture p66: CAD file, 2026-10-10]
cad/stl_print/P24_Toe.stl
78.0 x 86.5 x 11.0
