Basar-mte/CapLeg/ros2_ws/src/capleg_description/meshes/visual/capleg_shank_knee__pcb_green.stl

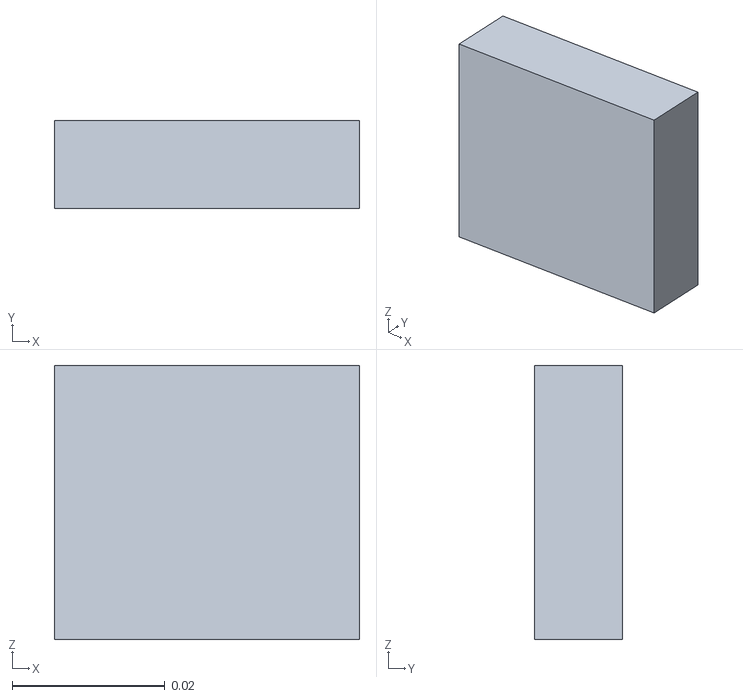
[picture p67: CAD file, 2026-10-10]
ros2_ws/src/capleg_description/meshes/visual/capleg_shank_knee__pcb_green.stl
0.04 x 0.0115 x 0.036
