Basar-mte/CapLeg/cad/stl_world/H14_AnkleCable_2.stl

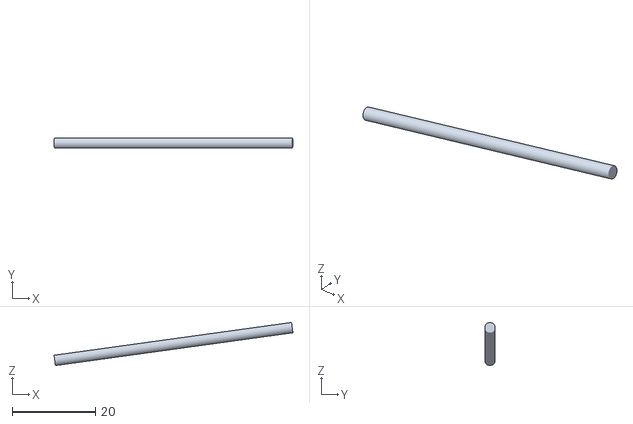
[picture p68: CAD file, 2026-10-10]
cad/stl_world/H14_AnkleCable_2.stl
57.4 x 2.49 x 10.3
