Basar-mte/CapLeg/mujoco/assets/capleg_thigh__graphite.stl

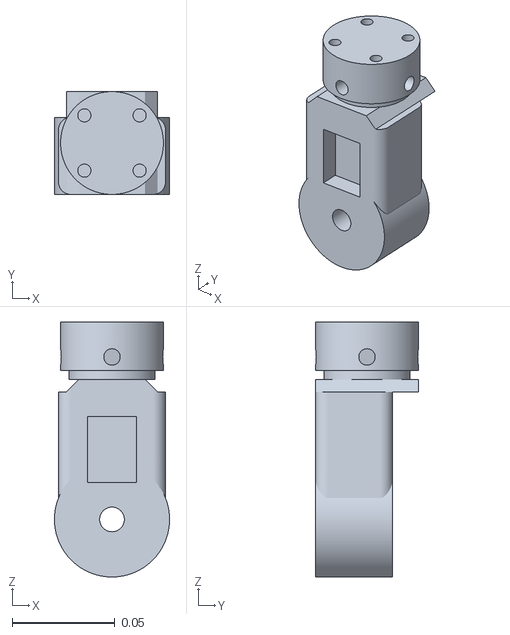
[picture p69: CAD file, 2026-10-10]
mujoco/assets/capleg_thigh__graphite.stl
0.056 x 0.05 x 0.124
