Basar-mte/CapLeg/cad/stl_world/H01_KneeAxle_D12.stl

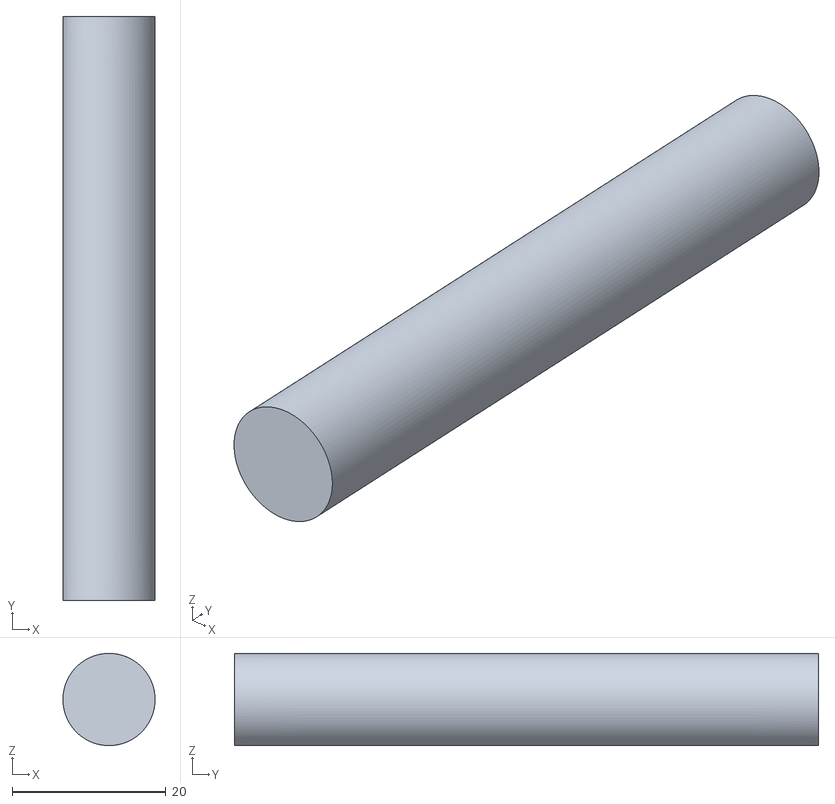
[picture p70: CAD file, 2026-10-10]
cad/stl_world/H01_KneeAxle_D12.stl
12.0 x 76.0 x 12.0
