Basar-mte/CapLeg/cad/stl_world/H10_Bearing6001_AnkleLat.stl

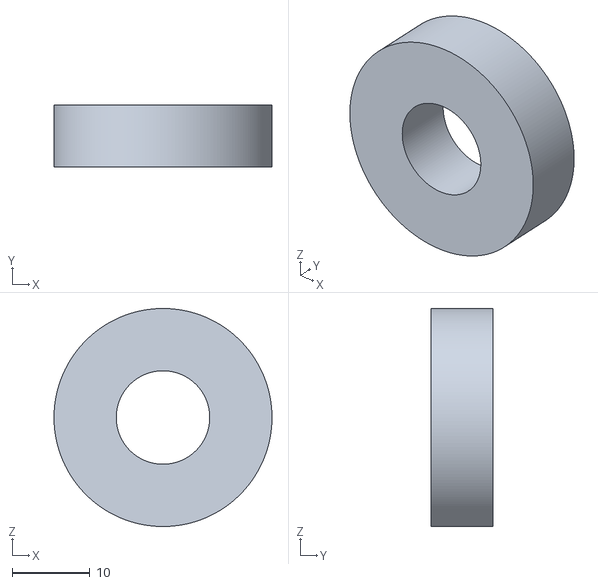
[picture p71: CAD file, 2026-10-10]
cad/stl_world/H10_Bearing6001_AnkleLat.stl
28.0 x 8.00 x 28.0
