Basar-mte/CapLeg/cad/stl_print/P19_Talus.stl

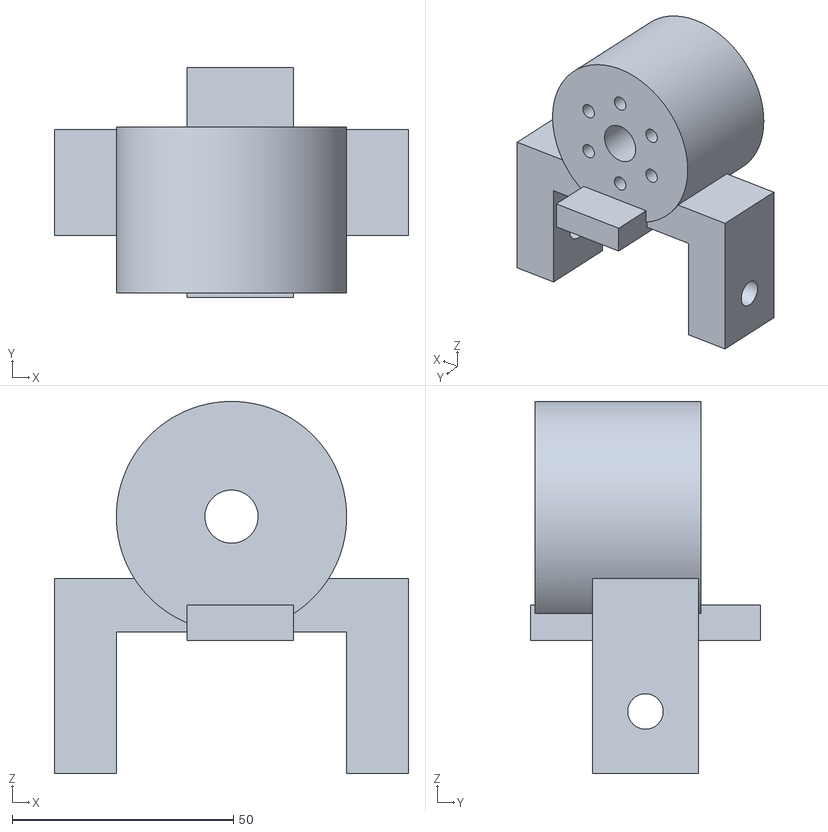
[picture p72: CAD file, 2026-10-10]
cad/stl_print/P19_Talus.stl
80.0 x 52.0 x 84.0
