Basar-mte/CapLeg/cad/stl_world/H42_RollAxle_D8.stl

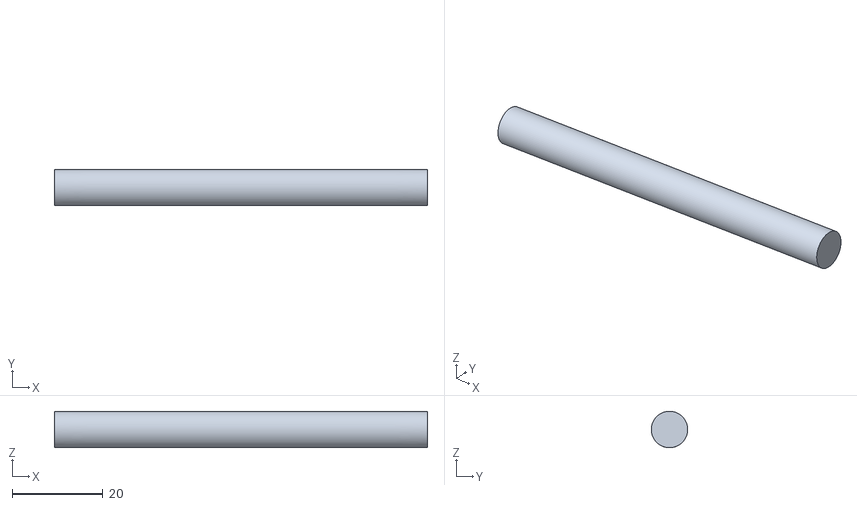
[picture p73: CAD file, 2026-10-10]
cad/stl_world/H42_RollAxle_D8.stl
82.0 x 8.00 x 8.00
