Basar-mte/CapLeg/cad/stl_print/P01_Socket.stl

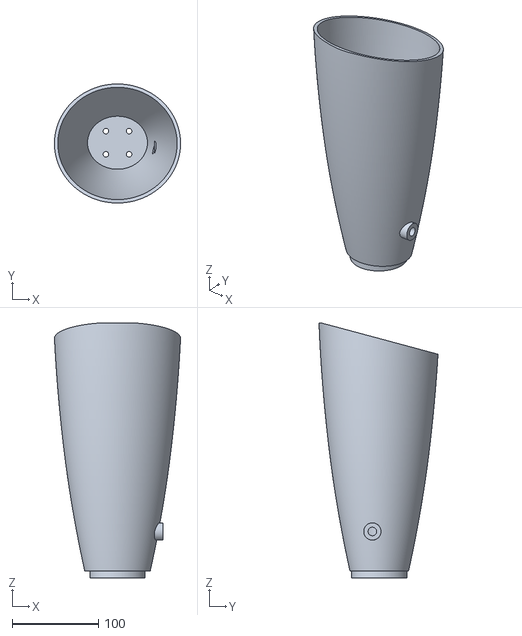
[picture p74: CAD file, 2026-10-10]
cad/stl_print/P01_Socket.stl
146.4 x 138.2 x 296.0
