Basar-mte/CapLeg/cad/stl_world/H11_Spacer_1.stl

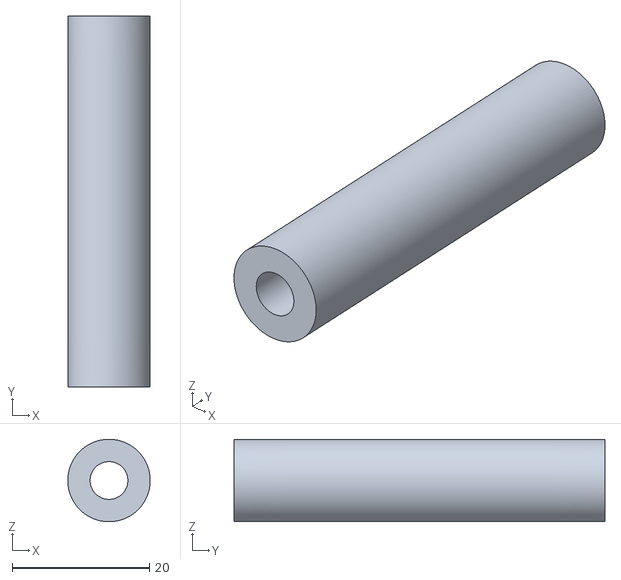
[picture p75: CAD file, 2026-10-10]
cad/stl_world/H11_Spacer_1.stl
12.0 x 54.0 x 12.0
