Basar-mte/CapLeg/cad/stl_world/H03_SuctionValve.stl

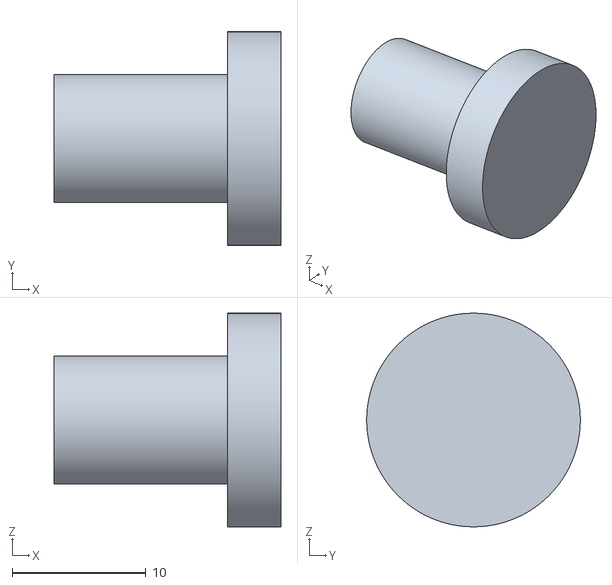
[picture p76: CAD file, 2026-10-10]
cad/stl_world/H03_SuctionValve.stl
17.0 x 16.0 x 16.0
