Basar-mte/CapLeg/cad/stl_world/H50_ToePin_D5.stl

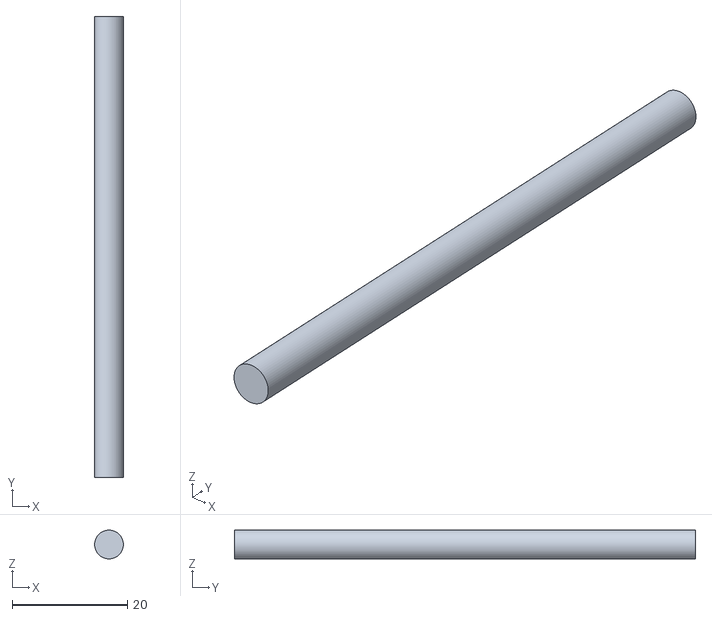
[picture p77: CAD file, 2026-10-10]
cad/stl_world/H50_ToePin_D5.stl
5.00 x 80.0 x 5.00
