Basar-mte/CapLeg/cad/stl_world/H40_AnkleAxle_D12.stl

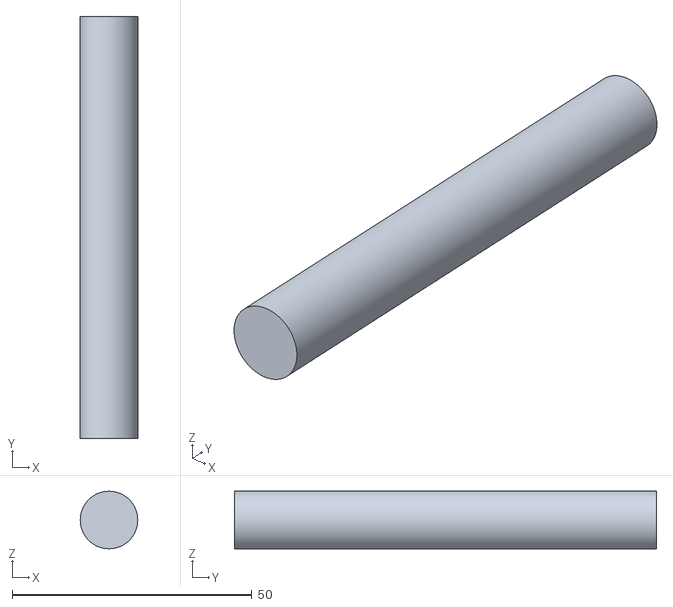
[picture p78: CAD file, 2026-10-10]
cad/stl_world/H40_AnkleAxle_D12.stl
12.0 x 88.0 x 12.0
