Basar-mte/CapLeg/cad/stl_world/H11_Spacer_2.stl

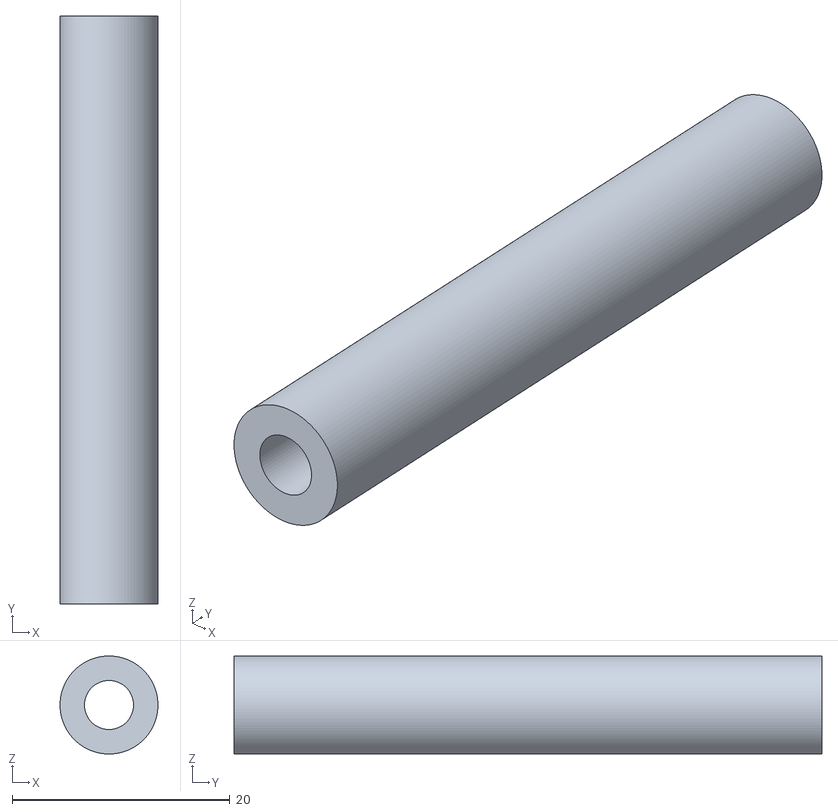
[picture p79: CAD file, 2026-10-10]
cad/stl_world/H11_Spacer_2.stl
9.00 x 54.0 x 8.99
