Basar-mte/CapLeg/cad/stl_world/H10_Bearing6000_AnkleDrum.stl

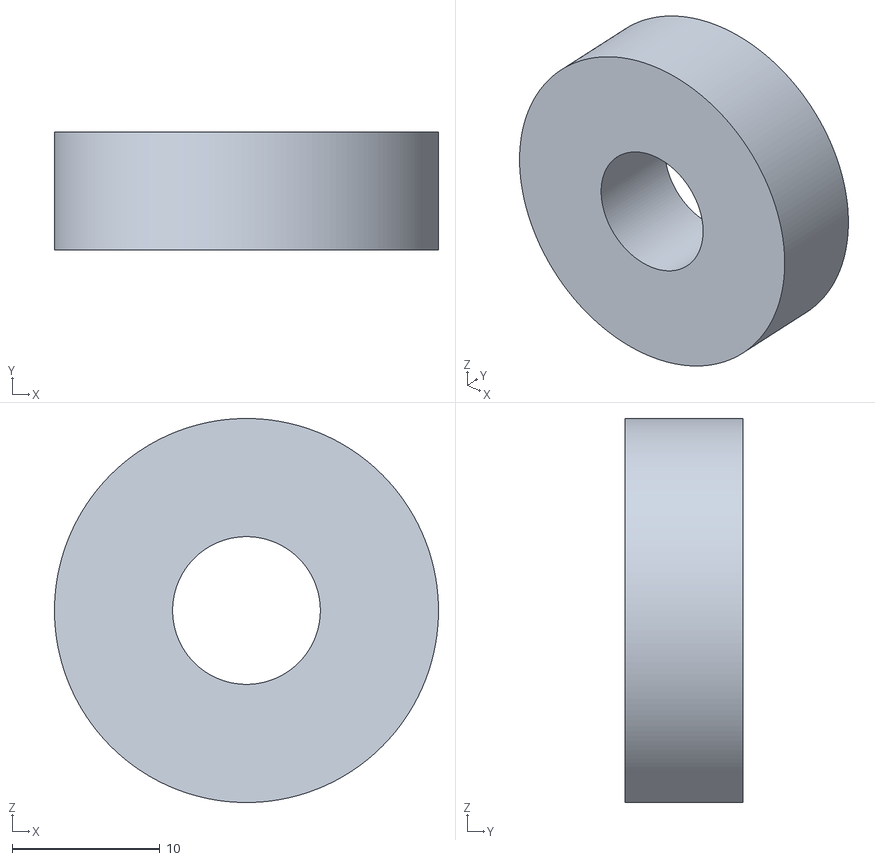
[picture p80: CAD file, 2026-10-10]
cad/stl_world/H10_Bearing6000_AnkleDrum.stl
26.0 x 8.00 x 26.0
