Basar-mte/CapLeg/cad/stl_world/H12_ElectronicsStack.stl

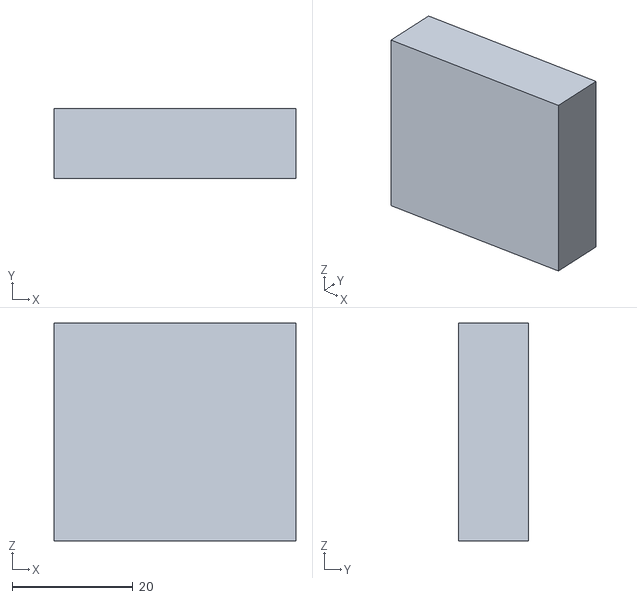
[picture p81: CAD file, 2026-10-10]
cad/stl_world/H12_ElectronicsStack.stl
40.0 x 11.5 x 36.0
