Basar-mte/CapLeg/cad/stl_world/H20_Pylon_D30.stl

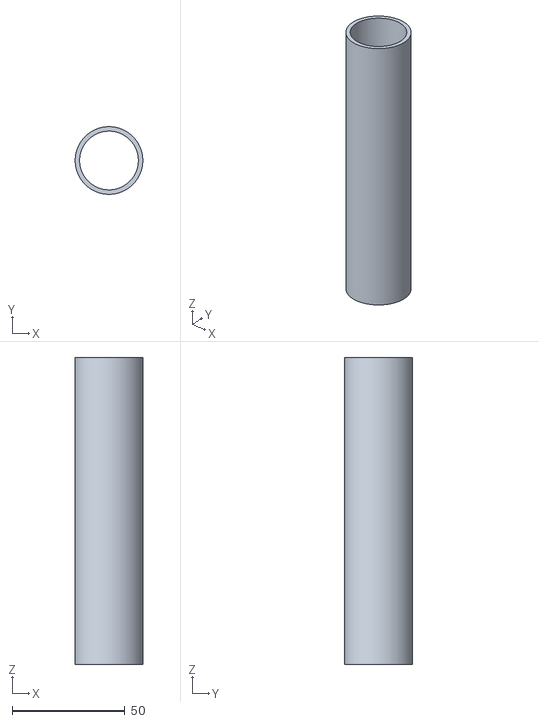
[picture p82: CAD file, 2026-10-10]
cad/stl_world/H20_Pylon_D30.stl
30.0 x 30.0 x 136.0
