Basar-mte/CapLeg/(list of files, cad)

Other CAD files:
cad/stl_world/P14_AnkleCover_Lat.stl
cad/stl_world/P03_KneeHead.stl
cad/stl_world/P12_AnklePlate_Med.stl
cad/stl_print/P11_AnklePlate_Lat.stl
cad/stl_print/P20_AnkleCapstanSector.stl
cad/stl_world/P04_KneeCapstanDisc.stl
ros2_ws/src/capleg_description/meshes/visual/capleg_ankle_module__steel.stl
cad/stl_print/P05_KneePlate_Lat.stl
cad/stl_world/P15_AnkleCover_Med.stl
cad/stl_world/H30_Actuator_AK80-9.stl
mujoco/assets/capleg_ankle_module__steel.stl
cad/stl_print/P21_FootKeel.stl
cad/stl_world/P02_PyramidReceiver.stl
cad/stl_print/P15_AnkleCover_Med.stl
cad/stl_world/P17_PylonClamp_Ankle.stl
ros2_ws/src/capleg_description/meshes/visual/capleg_shank_knee__actuator_black.stl
cad/stl_world/H51_Bearing608_Post.stl
mujoco/assets/capleg_shank_knee__actuator_black.stl
cad/stl_print/P18_CapstanDrum.stl
cad/stl_print/P09_KneeCover_Med.stl
cad/stl_print/P10_CapstanDrum.stl
cad/stl_world/H33_OutputFlange.stl
cad/stl_world/P16_PEA_SpringCartridge.stl
cad/stl_world/P23_RollSpring_TPU_Med.stl
cad/stl_world/P24_Toe.stl
cad/stl_world/H10_Bearing6001_KneeLat.stl
cad/stl_world/P07_KneeClamp.stl
cad/stl_world/P08_KneeCover_Lat.stl
cad/stl_world/P23_RollSpring_TPU_Lat.stl
cad/stl_world/P13_AnkleTopBlock.stl
cad/stl_world/P09_KneeCover_Med.stl
cad/stl_world/P18_CapstanDrum.stl
cad/stl_world/P06_KneePlate_Med.stl
cad/stl_world/H10_Bearing6000_KneeDrum.stl
cad/stl_world/P19_Talus.stl
cad/stl_world/H02_KneeCap_Med.stl
cad/stl_world/P22_SolePad_TPU.stl
cad/stl_world/H10_Bearing6001_AnkleMed.stl
cad/stl_world/P25_ToePad_TPU.stl
cad/stl_world/H10_Bearing6001_KneeMed.stl
cad/stl_world/H41_AnkleCap_Med.stl
cad/stl_world/P01_Socket.stl
cad/stl_world/H14_AnkleCable_1.stl
cad/CapLeg.f3d
