Basar-mte/CapLeg/mujoco/results/capleg_rig_log.csv

t | phase_true | phase_est | hip | hip_ref | knee | ankle | roll | toe | knee_ref | ankle_ref | knee_vel | ankle_vel | tau_knee | tau_ankle | pea | grf_x | grf_z | fz_rig | hip_z | hip_z_ref | foot_zmin | belt_x | load_cell_fz | qpos
0.0 | 0.0 | 0.005356980900797215 | 0.4520453122630471 | 0.45358288552590653 | 0.035489594823222816 | 0.001398305436820304 | 0.0 | 0.0 | 0.035489594823222816 | 0.001398305436820304 | 0.0 | 0.0 | 12.38980854092094 | -7.259150112055243 | 0.001398305436820304 | 0.0 | 0.0 | 44.46048814154056 | 0.8832591495121711 | 0.8810502285049547 | 0.007770661611072847 | 0.0006851259608672492 | -172.64923132572702 | 0.00069 -0.05674 0.45205 0.03448 0.00140 0.00001 0.00296
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
