Basar-mte/CapLeg/ros2_ws/src/capleg_description/urdf/generated/capleg_transfemoral.urdf

<?xml version="1.0"?>
<!-- CapLeg transfemoral (standalone). GENERATED by tools/build_sim_models.py -->
<robot name="capleg_transfemoral">
  <material name="capleg_accent_red"><color rgba="0.827 0.173 0.196 1"/></material>
  <material name="capleg_graphite"><color rgba="0.16 0.16 0.17 1"/></material>
  <material name="capleg_smoke_clear"><color rgba="0.55 0.57 0.6 0.55"/></material>
  <material name="capleg_aluminium"><color rgba="0.77 0.78 0.79 1"/></material>
  <material name="capleg_steel"><color rgba="0.65 0.66 0.67 1"/></material>
  <material name="capleg_actuator_black"><color rgba="0.09 0.09 0.1 1"/></material>
  <material name="capleg_tpu_black"><color rgba="0.07 0.07 0.07 1"/></material>
  <material name="capleg_cable_white"><color rgba="0.92 0.92 0.89 1"/></material>
  <material name="capleg_pcb_green"><color rgba="0.1 0.28 0.18 1"/></material>
  <link name="capleg_thigh">
    <inertial>
      <origin xyz="0.000277346 0.00328051 -0.308919" rpy="0 0 0"/>
      <mass value="1.15949"/>
      <inertia ixx="0.0197502" ixy="4.39148e-06" ixz="-9.15477e-06" iyy="0.0199917" iyz="0.000986456" izz="0.00221088"/>
    </inertial>
    <visual>
      <origin xyz="0 0 0" rpy="0 0 0"/>
      <geometry><mesh filename="../../meshes/visual/capleg_thigh__aluminium.stl"/></geometry>
      <material name="capleg_aluminium"/>
    </visual>
    <visual>
      <origin xyz="0 0 0" rpy="0 0 0"/>
      <geometry><mesh filename="../../meshes/visual/capleg_thigh__graphite.stl"/></geometry>
      <material name="capleg_graphite"/>
    </visual>
    <visual>
      <origin xyz="0 0 0" rpy="0 0 0"/>
      <geometry><mesh filename="../../meshes/visual/capleg_thigh__smoke_clear.stl"/></geometry>
      <material name="capleg_smoke_clear"/>
    </visual>
    <visual>
      <origin xyz="0 0 0" rpy="0 0 0"/>
      <geometry><mesh filename="../../meshes/visual/capleg_thigh__steel.stl"/></geometry>
      <material name="capleg_steel"/>
    </visual>
    <collision>
      <origin xyz="0 0 -0.18" rpy="0 3.14159 0"/>
      <geometry><cylinder radius="0.062" length="0.24"/></geometry>
    </collision>
  </link>
  <link name="capleg_thigh_imu_link"/>
  <joint name="capleg_thigh_imu_joint" type="fixed">
    <parent link="capleg_thigh"/>
    <child link="capleg_thigh_imu_link"/>
    <origin xyz="0 -0.02 -0.396" rpy="0 0 0"/>
  </joint>
  <joint name="knee" type="revolute">
    <parent link="capleg_thigh"/>
    <child link="capleg_shank"/>
    <origin xyz="0 0 -0.43" rpy="0 0 0"/>
    <axis xyz="0 1 0"/>
    <limit lower="-0.0872665" upper="2.0944" effort="102.34" velocity="12.45"/>
    <dynamics damping="0.2" friction="0.8"/>
  </joint>
  <link name="capleg_shank">
    <inertial>
      <origin xyz="-0.00216551 -0.000255995 -0.0961228" rpy="0 0 0"/>
      <mass value="1.37447"/>
      <inertia ixx="0.00712062" ixy="-8.98504e-05" ixz="9.62482e-05" iyy="0.00746095" iyz="8.08815e-05" izz="0.00189131"/>
    </inertial>
    <visual>
      <origin xyz="0 0 0" rpy="0 0 0"/>
      <geometry><mesh filename="../../meshes/visual/capleg_shank_knee__accent_red.stl"/></geometry>
      <material name="capleg_accent_red"/>
    </visual>
    <visual>
      <origin xyz="0 0 0" rpy="0 0 0"/>
      <geometry><mesh filename="../../meshes/visual/capleg_shank_knee__actuator_black.stl"/></geometry>
      <material name="capleg_actuator_black"/>
    </visual>
    <visual>
      <origin xyz="0 0 0" rpy="0 0 0"/>
      <geometry><mesh filename="../../meshes/visual/capleg_shank_knee__aluminium.stl"/></geometry>
      <material name="capleg_aluminium"/>
    </visual>
    <visual>
      <origin xyz="0 0 0" rpy="0 0 0"/>
      <geometry><mesh filename="../../meshes/visual/capleg_shank_knee__cable_white.stl"/></geometry>
      <material name="capleg_cable_white"/>
    </visual>
    <visual>
      <origin xyz="0 0 0" rpy="0 0 0"/>
      <geometry><mesh filename="../../meshes/visual/capleg_shank_knee__graphite.stl"/></geometry>
      <material name="capleg_graphite"/>
    </visual>
    <visual>
      <origin xyz="0 0 0" rpy="0 0 0"/>
      <geometry><mesh filename="../../meshes/visual/capleg_shank_knee__pcb_green.stl"/></geometry>
      <material name="capleg_pcb_green"/>
    </visual>
    <visual>
      <origin xyz="0 0 0" rpy="0 0 0"/>
      <geometry><mesh filename="../../meshes/visual/capleg_shank_knee__steel.stl"/></geometry>
      <material name="capleg_steel"/>
    </visual>
    <visual>
      <origin xyz="0 0 0" rpy="0 0 0"/>
      <geometry><mesh filename="../../meshes/visual/capleg_shank_pylon__aluminium.stl"/></geometry>
      <material name="capleg_aluminium"/>
    </visual>
    <collision>
      <origin xyz="-0.006 0 -0.1025" rpy="0 3.14159 0"/>
      <geometry><cylinder radius="0.058" length="0.125"/></geometry>
    </collision>
  </link>
  <link name="capleg_shank_imu_link"/>
  <joint name="capleg_shank_imu_joint" type="fixed">
    <parent link="capleg_shank"/>
    <child link="capleg_shank_imu_link"/>
    <origin xyz="0.03 0.019 -0.13" rpy="0 0 0"/>
  </joint>
  <link name="capleg_ankle_module">
    <inertial>
      <origin xyz="-0.0392061 -0.00586419 -0.0537836" rpy="0 0 0"/>
      <mass value="1.21217"/>
      <inertia ixx="0.00277873" ixy="9.89576e-05" ixz="0.000137555" iyy="0.00395443" iyz="-0.000269649" izz="0.00260406"/>
    </inertial>
    <visual>
      <origin xyz="0 0 0" rpy="0 0 0"/>
      <geometry><mesh filename="../../meshes/visual/capleg_ankle_module__accent_red.stl"/></geometry>
      <material name="capleg_accent_red"/>
    </visual>
    <visual>
      <origin xyz="0 0 0" rpy="0 0 0"/>
      <geometry><mesh filename="../../meshes/visual/capleg_ankle_module__actuator_black.stl"/></geometry>
      <material name="capleg_actuator_black"/>
    </visual>
    <visual>
      <origin xyz="0 0 0" rpy="0 0 0"/>
      <geometry><mesh filename="../../meshes/visual/capleg_ankle_module__aluminium.stl"/></geometry>
      <material name="capleg_aluminium"/>
    </visual>
    <visual>
      <origin xyz="0 0 0" rpy="0 0 0"/>
      <geometry><mesh filename="../../meshes/visual/capleg_ankle_module__cable_white.stl"/></geometry>
      <material name="capleg_cable_white"/>
    </visual>
    <visual>
      <origin xyz="0 0 0" rpy="0 0 0"/>
      <geometry><mesh filename="../../meshes/visual/capleg_ankle_module__graphite.stl"/></geometry>
      <material name="capleg_graphite"/>
    </visual>
    <visual>
      <origin xyz="0 0 0" rpy="0 0 0"/>
      <geometry><mesh filename="../../meshes/visual/capleg_ankle_module__steel.stl"/></geometry>
      <material name="capleg_steel"/>
    </visual>
    <collision>
      <origin xyz="-0.04 0 -0.0575" rpy="0 -2.28963 0"/>
      <geometry><cylinder radius="0.05" length="0.0531507"/></geometry>
    </collision>
  </link>
  <joint name="load_cell_joint" type="fixed">
    <parent link="capleg_shank"/>
    <child link="capleg_ankle_module"/>
    <origin xyz="0 0 -0.303" rpy="0 0 0"/>
  </joint>
  <link name="capleg_talus">
    <inertial>
      <origin xyz="-0.00869981 0.00798306 0.00319758" rpy="0 0 0"/>
      <mass value="0.406916"/>
      <inertia ixx="0.000425524" ixy="4.00308e-05" ixz="1.81778e-06" iyy="0.000517819" iyz="-6.08975e-05" izz="0.000343039"/>
    </inertial>
    <visual>
      <origin xyz="0 0 0" rpy="0 0 0"/>
      <geometry><mesh filename="../../meshes/visual/capleg_talus__aluminium.stl"/></geometry>
      <material name="capleg_aluminium"/>
    </visual>
    <visual>
      <origin xyz="0 0 0" rpy="0 0 0"/>
      <geometry><mesh filename="../../meshes/visual/capleg_talus__graphite.stl"/></geometry>
      <material name="capleg_graphite"/>
    </visual>
    <visual>
      <origin xyz="0 0 0" rpy="0 0 0"/>
      <geometry><mesh filename="../../meshes/visual/capleg_talus__steel.stl"/></geometry>
      <material name="capleg_steel"/>
    </visual>
  </link>
  <joint name="ankle_pitch" type="revolute">
    <parent link="capleg_ankle_module"/>
    <child link="capleg_talus"/>
    <origin xyz="0 0 -0.117" rpy="0 0 0"/>
    <axis xyz="0 -1 0"/>
    <limit lower="-0.349066" upper="0.261799" effort="176.5" velocity="11.47"/>
    <dynamics damping="0.2" friction="0.8"/>
  </joint>
  <link name="capleg_foot">
    <inertial>
      <origin xyz="0.0263287 -0.000351722 -0.0279072" rpy="0 0 0"/>
      <mass value="0.27316"/>
      <inertia ixx="0.000161826" ixy="-4.11363e-06" ixz="5.82838e-05" iyy="0.000716938" iyz="-4.17041e-07" izz="0.000753185"/>
    </inertial>
    <visual>
      <origin xyz="0 0 0" rpy="0 0 0"/>
      <geometry><mesh filename="../../meshes/visual/capleg_foot__accent_red.stl"/></geometry>
      <material name="capleg_accent_red"/>
    </visual>
    <visual>
      <origin xyz="0 0 0" rpy="0 0 0"/>
      <geometry><mesh filename="../../meshes/visual/capleg_foot__graphite.stl"/></geometry>
      <material name="capleg_graphite"/>
    </visual>
    <visual>
      <origin xyz="0 0 0" rpy="0 0 0"/>
      <geometry><mesh filename="../../meshes/visual/capleg_foot__steel.stl"/></geometry>
      <material name="capleg_steel"/>
    </visual>
    <visual>
      <origin xyz="0 0 0" rpy="0 0 0"/>
      <geometry><mesh filename="../../meshes/visual/capleg_foot__tpu_black.stl"/></geometry>
      <material name="capleg_tpu_black"/>
    </visual>
    <collision>
      <origin xyz="-0.052 0.018 -0.028" rpy="0 0 0"/>
      <geometry><sphere radius="0.018"/></geometry>
    </collision>
    <collision>
      <origin xyz="-0.052 -0.018 -0.028" rpy="0 0 0"/>
      <geometry><sphere radius="0.018"/></geometry>
    </collision>
    <collision>
      <origin xyz="0.104 0.03 -0.034" rpy="0 0 0"/>
      <geometry><sphere radius="0.012"/></geometry>
    </collision>
    <collision>
      <origin xyz="0.104 -0.026 -0.034" rpy="0 0 0"/>
      <geometry><sphere radius="0.012"/></geometry>
    </collision>
    <collision>
      <origin xyz="0.03 -0.03 -0.036" rpy="0 0 0"/>
      <geometry><sphere radius="0.01"/></geometry>
    </collision>
  </link>
  <joint name="ankle_roll" type="revolute">
    <parent link="capleg_talus"/>
    <child link="capleg_foot"/>
    <origin xyz="0 0 -0.044" rpy="0 0 0"/>
    <axis xyz="1 0 0"/>
    <limit lower="-0.174533" upper="0.174533" effort="60" velocity="10"/>
    <dynamics damping="0.5" friction="0.05"/>
  </joint>
  <link name="capleg_foot_imu_link"/>
  <joint name="capleg_foot_imu_joint" type="fixed">
    <parent link="capleg_foot"/>
    <child link="capleg_foot_imu_link"/>
    <origin xyz="0.04 0 -0.031" rpy="0 0 0"/>
  </joint>
  <link name="capleg_heel_link"/>
  <joint name="capleg_heel_joint" type="fixed">
    <parent link="capleg_foot"/>
    <child link="capleg_heel_link"/>
    <origin xyz="-0.052 0 -0.046" rpy="0 0 0"/>
  </joint>
  <link name="capleg_ball_link"/>
  <joint name="capleg_ball_joint" type="fixed">
    <parent link="capleg_foot"/>
    <child link="capleg_ball_link"/>
    <origin xyz="0.104 0 -0.046" rpy="0 0 0"/>
  </joint>
  <link name="capleg_toe">
    <inertial>
      <origin xyz="0.0326931 0.00354203 -0.00382029" rpy="0 0 0"/>
      <mass value="0.0653597"/>
      <inertia ixx="3.35e-05" ixy="-1.72005e-06" ixz="2.69176e-07" iyy="2.57859e-05" iyz="5.28456e-08" izz="5.71212e-05"/>
    </inertial>
    <visual>
      <origin xyz="0 0 0" rpy="0 0 0"/>
      <geometry><mesh filename="../../meshes/visual/capleg_toe__graphite.stl"/></geometry>
      <material name="capleg_graphite"/>
    </visual>
    <visual>
      <origin xyz="0 0 0" rpy="0 0 0"/>
      <geometry><mesh filename="../../meshes/visual/capleg_toe__tpu_black.stl"/></geometry>
      <material name="capleg_tpu_black"/>
    </visual>
    <collision>
      <origin xyz="0.03 0.022 -0.0025" rpy="0 0 0"/>
      <geometry><sphere radius="0.009"/></geometry>
    </collision>
    <collision>
      <origin xyz="0.03 -0.02 -0.0025" rpy="0 0 0"/>
      <geometry><sphere radius="0.009"/></geometry>
    </collision>
    <collision>
      <origin xyz="0.06 0.012 -0.0025" rpy="0 0 0"/>
      <geometry><sphere radius="0.009"/></geometry>
    </collision>
  </link>
  <joint name="toe" type="revolute">
    <parent link="capleg_foot"/>
    <child link="capleg_toe"/>
    <origin xyz="0.12 0 -0.0345" rpy="0 0 0"/>
    <axis xyz="0 -1 0"/>
    <limit lower="0" upper="0.698132" effort="35" velocity="15"/>
    <dynamics damping="0.05" friction="0.02"/>
  </joint>
  <link name="capleg_toe_tip_link"/>
  <joint name="capleg_toe_tip_joint" type="fixed">
    <parent link="capleg_toe"/>
    <child link="capleg_toe_tip_link"/>
    <origin xyz="0.07 0 -0.0115" rpy="0 0 0"/>
  </joint>
</robot>
